cristobalgc/STM32_PID_CONTROLLER/README.md

# STM32_PID_CONTROLLER
A PID Controller with configurable parameters using LCD and a rotary encoder.
