cristobalgc/STM32_PID_CONTROLLER/Doc/Stm32F103_Eval_Doc.tex

\documentclass[10pt,a4paper,oneside]{article}
\include{Formato}
%--------------------------------------------------------------------------------------------------
\begin{document}

% PORTADA %%%%%%%%%%%%%%%%%%%%%%%%%%%%%%%%%%%%%%%%%%%%%%%%%%%%%%%%%%%%%%%%%%%%%%%%%%%%%%%%%%%%%%%%%%
\pagestyle{empty}

\begin{center} 
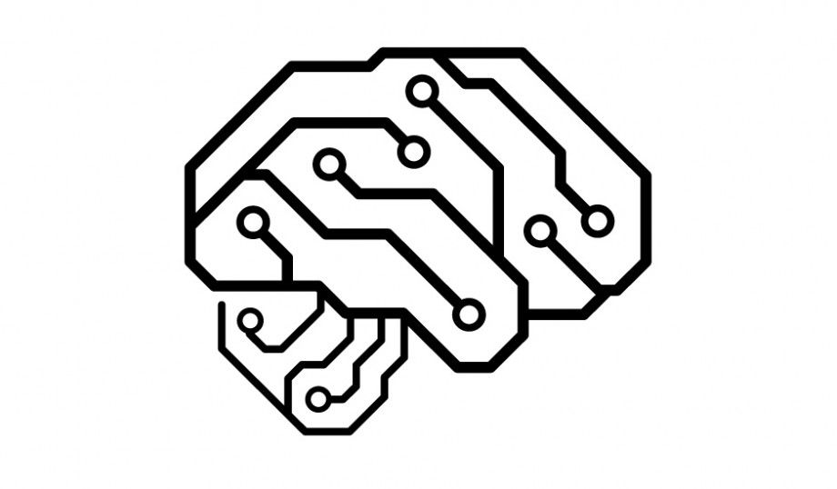
[picture p1: Doc/Imagenes/PCB_Brain_circuit.png]
 
\end{center}

\large

\vspace{3cm}

\begin{center}
{\setlength\arrayrulewidth{2pt}
\begin{tabular}{r|p{9.8cm}}
\arrayrulecolor{udc}
\colorbox{udc}{\textcolor{white}{\bf TÍTULO}}      
&	DISEÑO Y CONSTRUCCION DE UNA PLACA DE DESARROLLO PARA EL MICROCONTROLADOR STM32F103C8T6  \\[2cm]
%\colorbox{udc}{\textcolor{white}{\bf GRADO}}       & Dual en Ingeñaría Eléctrica    \\[1cm]
\colorbox{udc}{\textcolor{white}{\bf AMBITO}}       & Ingenería Electrónica    \\[1cm]
\colorbox{udc}{\textcolor{white}{\bf }}  &      \\[2cm]
\colorbox{udc}{\textcolor{white}{\bf AUTOR}}  &	Garcia Camoira Cristobal  \\[2cm]
%                                                  &	Apellido1 Apellido 2, Nombres  \\[2cm]
\colorbox{udc}{\textcolor{white}{FECHA}}       &	Febrero de 2022
\end{tabular}}
\end{center}
\normalsize
% FIN DE LA PORTADA %%%%%%%%%%%%%%%%%%%%%%%%%%%%%%%%%%%%%%%%%%%%%%%%%%%%%%%%%%%%%%%%%%%%%%%%%%%%%%%%%%%%%%%%%%%%%%%%%%%%%%%%%%%%% -----------------------------------------------------------------------------------------------------------------------------------
\cleardoublepage

% Índice de contenidos
\pagestyle{plain}
\renewcommand{\contentsname}{Índice}
{\hypersetup{hidelinks}\tableofcontents}

\cleardoublepage

% Página que contiene el índice de listas de figuras
\phantomsection
\renewcommand*\listfigurename{Listado de figuras}
\addcontentsline{toc}{section}{\listfigurename}
{\hypersetup{hidelinks}\listoffigures}
\addtocontents{lof}{\protect\thispagestyle{plain}}

% Página que contiene el índice de listas de tablas
%\cleardoublepage
\phantomsection
\renewcommand*\listtablename{Listado de tablas}
\addcontentsline{toc}{section}{\listtablename}
{\hypersetup{hidelinks}\listoftables}
\addtocontents{lot}{\protect\thispagestyle{plain}}

% Página que contiene el índice de listados de programación
\renewcommand\lstlistlistingname{Listado de códigos de programación}
\renewcommand\lstlistingname{Código}
%\cleardoublepage
\phantomsection
\addcontentsline{toc}{section}{\lstlistlistingname}
{\hypersetup{hidelinks}\lstlistoflistings}
{\protect\thispagestyle{plain}}

% Final del índice -----------------------------------------------------------------------------------------------------------------------------------

\cleardoublepage %-----------------------------------------------------------------------------------------------------

\pagestyle{fancy}

\addcontentsline{toc}{section}{Introducción}%--------------------------------------------------------------------------------
\section*{Introducción}

El presente proyecto tiene como objetivo la realización de un sistema de evaluación que nos permita el uso de diferentes periféricos así como el uso de diferentes tipos de comunicación con diversos dispositivos. 

\section*{Características técnicas}

Este sistema poseerá las siguientes salidas:

\begin{enumerate}
	\item Salida para comunicación UART
	\item Salida para comunicación IIC
	\item Salida PWM
\end{enumerate}

Y también las siguientes entradas:

\begin{enumerate}
	\item Entrada ADC
	\item Entrada JTAG para la programación del microcontrolador
	\item Entrada para una batería auxiliar tipo CR2032 que usara el dispositivo DS1302 para mantener la hora en caso de que se desconecte la alimentación  principal.
\end{enumerate}

Este sistema incorporara internamente un LCD de 20 caracteres x 4 lineas que se conectara a nuestro microcontrolador través del expansor de entradas/salidas IIC PCF8574, ademas incorpora un DS1302, un reloj en tiempo real el cual se ha pensado manejar con el sistema de conexión 1 wire, para el cual se usara el periférico interno SPI en modo half duplex.Todo esto nos permitirá el desarrollo de drivers para el correcto manejo de los dispositivos internos que posee y aprender de ello. Ademas las salidas que tenemos disponibles nos servirán para manejar otro tipo de dispositivos, dado que tenemos salida PWM, IIC y UART y una entrada para un ADC.

El microcontrolador que se usara en el proyecto pertenece al fabricante ST microelectronics, concretamente es el STM32F103C8T6, que incorporaremos a nuestro sistema ya en una placa de evaluación comúnmente denominada por la red de internet como "`Blue pill"', de hecho, si descargamos las librerías adecuadas se puede usar el entrono de Arduino para su programación, como si de un Arduino se tratase.

La alimentación de este sistema se hará a través del conector micro USB del que dispone la placa de evaluación de ST, un cargador de teléfono móvil sera mas que suficiente, 5V 1A, el resto de componentes internos se nutrirán de la alimentación de 5V que proporciona la placa de evaluación de ST dado que usa un regulador interno para ello y la corriente que proporciona es capaz de nutrir de forma suficiente al resto de componentes.

\vspace{0.5cm}

\section{Lista de materiales y presupuesto}

% Table generated by Excel2LaTeX from sheet 'BOM'
\begin{center}
\begin{longtable}{|l|l|l|l|l|}

%primera parte de la tabla
\rowcolor[rgb]{ .357,  .608,  .835} \textcolor[rgb]{ 1,  1,  1}{\textbf{Category}} & \textcolor[rgb]{ 1,  1,  1}{\textbf{Quantity}} & \textcolor[rgb]{ 1,  1,  1}{\textbf{References}} & \textcolor[rgb]{ 1,  1,  1}{\textbf{Value}} & \textcolor[rgb]{ 1,  1,  1}{\textbf{Unit Cost}} \\
\endfirsthead
%Continuación de la tabla \\
\rowcolor[rgb]{ .357,  .608,  .835} \textcolor[rgb]{ 1,  1,  1}{\textbf{Category}} & \textcolor[rgb]{ 1,  1,  1}{\textbf{Quantity}} & \textcolor[rgb]{ 1,  1,  1}{\textbf{References}} & \textcolor[rgb]{ 1,  1,  1}{\textbf{Value}} & \textcolor[rgb]{ 1,  1,  1}{\textbf{Unit Cost}} \\
\endhead

% ultima parte de la tabla por pagina
%\multicolumn{6}{c}{ \textit{Presupuesto de dispositivos}-(ver pag siguiente)}  \\ 
\caption[Lista de materiales]{Lista de materiales}
%Continua en la siguiente pagina \\
\endfoot

% ultima parte de la tabla
\caption[Lista de materiales]{Lista de materiales}\label{TABLA1}
\endlastfoot

\midrule
Capacitors & 2      & C1-C2  & 6pF    & €0,35 \\
\midrule
Capacitors & 1      & C3     & 1.0u   & €0,35 \\
\midrule
Capacitors & 2      & C4-C5  & 10n    & €0,35 \\
\midrule
Capacitors & 1      & C6     & 100n   & €1,00 \\
\midrule
Resistors & 1      & R1     & 1k     & €0,15 \\
\midrule
Resistors & 9      & R2-R10 & 10k    & €0,15 \\
\midrule
Integrated Circuits & 1      & U1     & STM32F103 & €3,50 \\
\midrule
Integrated Circuits & 1      & U2     & 74HC14 & €1,00 \\
\midrule
Integrated Circuits & 1      & U3     & PCF8574 & €2,50 \\
\midrule
Integrated Circuits & 1      & U6     & DS1302 & €1,00 \\
\midrule
Miscellaneous & 2      & ADC,UART & CONN-SIL3 & €0,40 \\
\midrule
Miscellaneous & 1      & BATT   & CONN-H2 & €0,35 \\
\midrule
Miscellaneous & 2      & IIC,JTAG & CONN-H4 & €0,40 \\
\midrule
Miscellaneous & 1      & L1     &        & €0,25 \\
\midrule
Miscellaneous & 1      & LCD\_20X4 & CONN-H16 & €4,50 \\
\midrule
Miscellaneous & 1      & PWM    & CONN-SIL5 & €0,25 \\
\midrule
Miscellaneous & 1      & RENC1  & ROTARY\_ENCODER1 & €2,50 \\
\midrule
Miscellaneous & 1      & X1     & CRYSTAL & €0,50 \\
\midrule
\textbf{Total} &        &        &        & €22,2 \\
\bottomrule

\end{longtable}
\end{center}

\section{Montaje}
\subsection{Guía de montaje}%------------------------------------------------------------------------------------------------------

El proceso de insolado no se explica en esta guía, con lo cual se explica el proceso de montaje una vez tenemos la PCB tras ese proceso y el proceso de taladrado de los agujeros. Se incluye como ejemplo la Figura (\ref{fig:001}).

\begin{figure}[H]
\centering
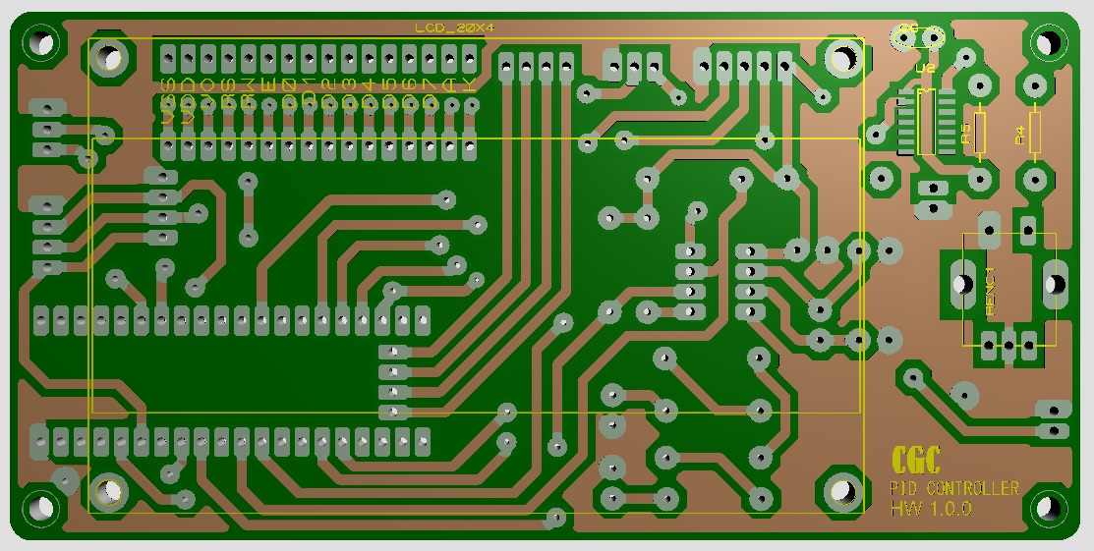
[picture p2: Doc/Imagenes/PCB_CARA_DELANTERA.jpg]

\caption[Vista de las pistas de la cara delantera de la PCB tras el proceso de insolado]{Pistas PCB cara delantera}
\label{fig:001}
\end{figure}

\begin{figure}[H]
\centering
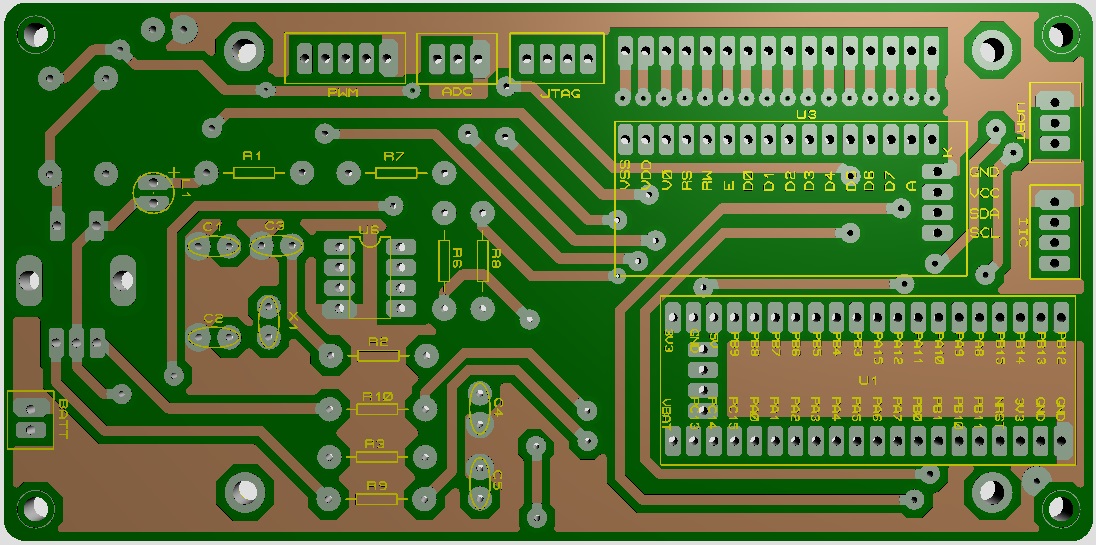
[picture p3: Doc/Imagenes/PCB_CARA_TRASERA.jpg]

\caption[Vista de las pistas de la cara trasera de la PCB tras el proceso de insolado]{Pistas PCB cara trasera}
\label{fig:002}
\end{figure}

Teniendo como referencia la PCB por la cara delantera,  tal y como se representa en la imagen (\ref{fig:003}), los círculos señalados en amarillo son las vías, es decir, los puntos que conectan ambas caras, delantera y trasera, esta conexión la haremos con unos cables rígidos que circularan de un lado al otro de la placa, soldados por ambas caras, para ello se puede usar un trozo de cable rígido pelado previamente. 

\begin{figure}[H]
\centering
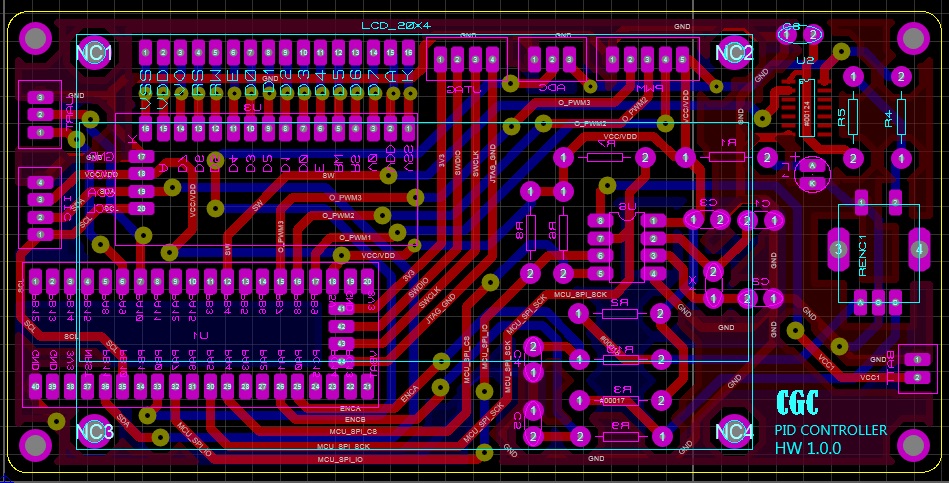
[picture p4: Doc/Imagenes/PCB_CARA_DELANTERA_VIAS.jpg]

\caption[Vista de las vias de la cara delantera de la PCB tras el proceso de insolado]{Vías PCB cara delantera}
\label{fig:003}
\end{figure}

Una vez soldadas las vías, se recomienda ir soldando los componentes que vayan de menor a mayor volumen o tamaño para facilitar este proceso, se recomienda empezar por soldar los que van por la parte trasera (\ref{fig:005}).

Nota: No es necesario incorporar los componentes R6, R7 y R8 al circuito, en su defecto es necesario soldar un cable en cada uno de los pads de las resistencias para unir ambas caras de la placa, como si de vías se tratasen.

Por la cara delantera irán soldados los componentes: R4, R5, U2, C6, RENC1 y LCD20X4. El resto de componentes irán soldados por la parte trasera.

\begin{figure}[H]
\centering
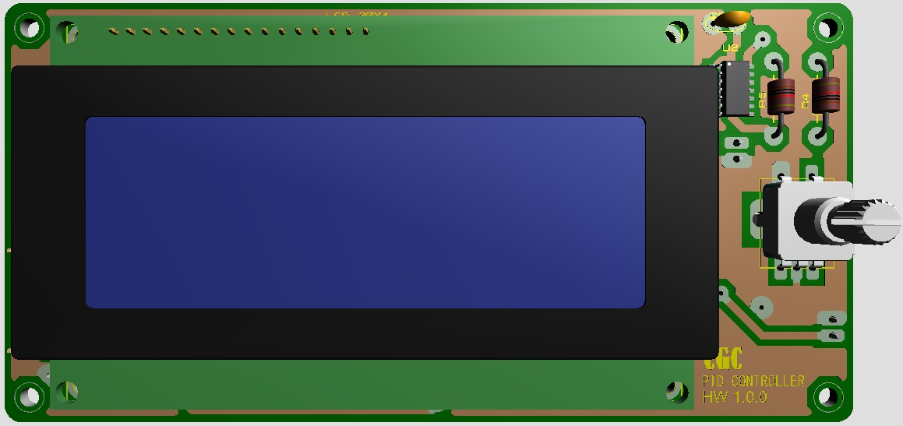
[picture p5: Doc/Imagenes/PCB_COMPONENTES_CARA_DELANTERA.jpg]

\caption[Vista de los componentes de la cara delantera de la PCB]{Componentes de la cara delantera}
\label{fig:004}
\end{figure}

\begin{figure}[H]
\centering
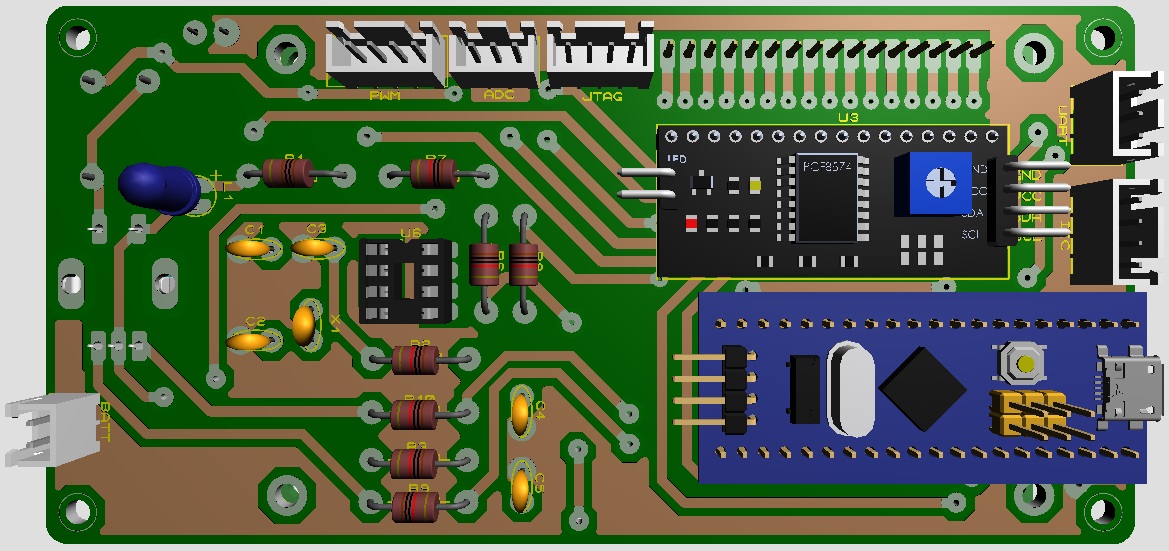
[picture p6: Doc/Imagenes/PCB_COMPONENTES_CARA_TRASERA.jpg]

\caption[Vista de los componentes de la cara trasera de la PCB]{Componentes de la cara trasera}
\label{fig:005}
\end{figure}

\begin{figure}[h]
\centering
\includemovie[
 poster,controls,
 3Droo=23, 3Dcoo=-1 9.8765 0
 ]{17cm}{9cm}{Model3D/PCB_3D_MODEL.u3d}
 \caption[Vista 3D del modelo de la PCB]{Modelo 3D de la PCB}
\label{fig:PCB_3D_MODEL}
\end{figure}

\subsection{Programación del dispositivo}%------------------------------------------------------------------------------------------------------

Para la programación de este dispositivo se deben ejecutar los siguientes pasos:

\begin{enumerate}
	\item Conectar los pines del conector JTAG con sus homólogos en el programador stlink-V2.
	\item El código se encuentra en la siguiente dirección: \url{https://github.com/cristobalgc/STM32_PID_CONTROLLER}
	\item Esta sección se completara cuando el código este acabado.
\end{enumerate}

\section{Códigos de programación}%-------------------------------------------------------------------------------------------------

El código de programación del dispositivo estará localizado en el siguiente repositorio de github: \url{https://github.com/cristobalgc/STM32_PID_CONTROLLER}

\bigskip

\section{Sección Planos}%------------------------------------------------------------------------------------------------------

A continuación se introducen los planos. Cada plano figura en una página separada con numeración impar. La parte posterior de esas hojas deben estar en blanco.

%\pagestyle{fancy}

% FIN DE LA PORTADA
%%%%%%%%%%%%%%%%%%%%%%%%%%%%%%%%%%%%%%%%%%%%%%%%%%%%%%%%%%%%%%%%%%%%%%%%%%%%%%%%%%%%%%%%%%%%%%%%%%%%%%%%%%%%%%%%%%%%%%%%%%%%%%%%%%%%%%

% Principio Plano A4 ---------------------------------------------------------------------------------------------------
\cleardoublepage
\begin{Plano}[!htb]
\addcontentsline{toc}{subsection}{Esquema electrónico de la placa Blue pill} % Nombre que aparecerá en la lista de planos
\includepdf[pages=-]{Planos/STM32F103C8T6-Blue_Pill-schematic.pdf} % Ruta y nombre del plano A4
\caption[Esquema electrónico de la placa Blue pill]{} % Página \thepage}
\label{BluePillSch} % Etiqueta para referenciar el plano
\end{Plano}

% Fin Plano A4 --------------------------------------------------------------------------------------------------------

% Principio Plano A4 ---------------------------------------------------------------------------------------------------
\cleardoublepage
\begin{Plano}[!htb]
\addcontentsline{toc}{subsection}{Esquema electrónico del expansor de entradas-salidas IIC} % Nombre que aparecerá en la lista de planos
\includepdf[pages=-]{Planos/PCF8574_IO_Expander_schematic.pdf} % Ruta y nombre del plano A4
\caption[Esquema electrónico del expansor de entradas-salidas IIC]{} % Página \thepage}
\label{PCF8574Sch} % Etiqueta para referenciar el plano
\end{Plano}

% Fin Plano A4 --------------------------------------------------------------------------------------------------------

% Principio Plano A3 ---------------------------------------------------------------------------------------------------
\cleardoublepage

\begin{landscape} % se indica que empieza una página apaisada
\afterpage

\KOMAoptions{paper=A3,paper=landscape,pagesize}
\recalctypearea
\begin{Plano}[!htb]
\addcontentsline{toc}{subsection}{Placa de evaluación ST} % Nombre que aparecerá en la lista de planos
\includepdf[pages=-]{Planos/PCB_PLACA_EVAL_ST_SCHEMATIC.pdf} % Ruta y nombre del plano A3
\caption[Placa de evaluación ST]{}
\label{PacaEvalSch} % Etiqueta para referenciar el plano
\end{Plano}

\cleardoublepage

\KOMAoptions{paper=A4,pagesize}
\recalctypearea
\end{landscape} % se indica que acaba una página apaisada
% Fin Plano A3 --------------------------------------------------------------------------------------------------------

\cleardoublepage

% Principio Plano A4 ---------------------------------------------------------------------------------------------------
\cleardoublepage
\begin{Plano}[!htb]
\addcontentsline{toc}{subsection}{Fotolito PCB parte delantera} % Nombre que aparecerá en la lista de planos
\includepdf[pages=-]{Planos/FOTOLITO_PCB_PARTE_DELANTERA.pdf} % Ruta y nombre del plano A4
\caption[Fotolito PCB parte delantera]{} % Página \thepage}
\label{FotolitoTOP} % Etiqueta para referenciar el plano
\end{Plano}

% Fin Plano A4 --------------------------------------------------------------------------------------------------------

% Principio Plano A4 ---------------------------------------------------------------------------------------------------
\cleardoublepage
\begin{Plano}[!htb]
\addcontentsline{toc}{subsection}{Fotolito PCB parte trasera} % Nombre que aparecerá en la lista de planos
\includepdf[pages=-]{Planos/FOTOLITO_PCB_PARTE_TRASERA.pdf} % Ruta y nombre del plano A4
\caption[Fotolito PCB parte trasera]{} % Página \thepage}
\label{FotolitoBOT} % Etiqueta para referenciar el plano
\end{Plano}

% Fin Plano A4 --------------------------------------------------------------------------------------------------------

%%%%%%%%%%%%%%%%%%%%%%%%%%%%%%%%%%%%%%%%%%%%%%%%%%%%%%%%%%%%%%%%%%%%%%%%%%%%%%%%%%%%%%%%%%%%%%%%%%%%%%%%%%%%%%%%%%%%%%%%%%%%%%%%%%%%%%

\end{document}
