cristobalgc/STM32_PID_CONTROLLER/Doc/Stm32F103_Eval_Doc.pdf

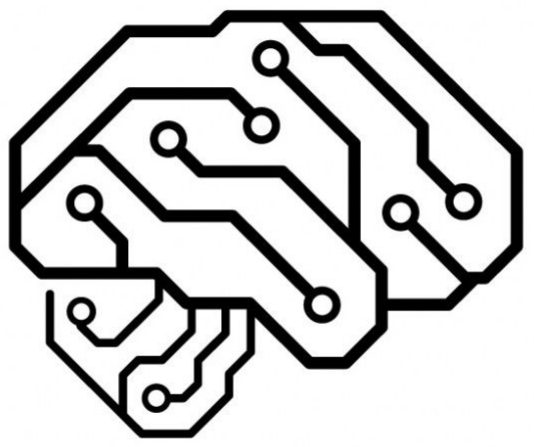
[picture p7: figure]

### T´ITULO DISENO Y CONSTRUCCION DE UNA PLACA DE ˜

### DESARROLLO PARA EL MICROCONTROLADOR

| STM32F103C8T6
GRADO | Ingener´ıa Electronica Industrial y Autom ´ | atica ´
ASIGNATURA | Nombre de la asignatura
ESTUDIANTE | Garcia Camoira Cristobal
FECHA | Octubre de 2020

## ´Indice

Listado de figuras | | 3
Listado de tablas | | 3
Listado de codigos de programaci ´ | on | 3 ´
Introduccion´ | | 4
1 Lista de materiales y presupuesto | 4
2 Montaje | | 6
2.1 Gu´ıa de montaje | | 6
2.2 Programacion del dispositivo | ´ | | 8
3 Codigos de programaci ´ | on´ | 8
4 Seccion Planos ´ | | 8
Esquema electronico de la placa Blue pill | ´ | | 9
Esquema electronico del expansor de entradas-salidas IIC | ´ | | 10
Placa de evaluacion ST | ´ | | 11
Fotolito PCB parte delantera | 12
Fotolito PCB parte trasera | 13

2

## Listado de figuras

1 | Vista de las pistas de la cara delantera de la PCB tras el proceso de insolado | | 6
2 | Vista de las pistas de la cara trasera de la PCB tras el proceso de insolado | | 6
3 | Vista de las vias de la cara delantera de la PCB tras el proceso de insolado | | 7
4 | Vista de los componentes de la cara delantera de la PCB | | 7
5 | Vista de los componentes de la cara trasera de la PCB | | 8

## Listado de tablas

1 | Lista de materiales | | 4
1 | Lista de materiales | | 5
2 | Presupuesto | | 5
Listado de codigos de programaci ´ | on´

3

## Introduccion´

El presente proyecto tiene como objetivo la realizacion de un sistema de evaluaci ´ | on que nos permita el uso ´
de diferentes perifericos as ´ | ´ı como el uso de diferentes tipos de comunicacion con diversos dispositivos. ´

## Caracter´ısticas tecnicas ´

Este sistema poseera las siguientes salidas: ´

1. Salida para comunicacion UART ´
2. Salida para comunicacion IIC ´
3. Salida PWM

Y tambien las siguientes entradas: ´

1. Entrada ADC
2. Entrada JTAG para la programacion del microcontrolador ´
3. Entrada para una bater´ıa que usara el DS1302 para que no se vaya de hora

Este sistema incorporara internamente un LCD de 20 caracteres x 4 lineas que se conectara a nuestro microcontrolador traves del expansor de entradas/salidas IIC PCF8574, ademas incorpora un DS1302, un ´
reloj en tiempo real el cual se ha pensado manejar con el sistema de conexion 1 wire (conexi ´ | on experimental), ´
para el cual intentaremos usar el periferico interno USART.Todo esto nos permitir ´ | a el desarrollo de drivers ´

para el correcto manejo de los dispositivos internos que posee y aprender de ello. Ademas las salidas que tenemos disponibles nos serviran para manejar otro tipo de dispositivos, dado que tenemos salida PWM, IIC ´ y UART y una entrada para un ADC.
El microcontrolador que se usara en el proyecto pertenece al fabricante ST microelectronics, concretamen-
te es el STM32F103C8T6, que incorporaremos a nuestro sistema ya en una placa de evaluacion com ´ | unmente ´

denominada por la red de internet como ✭✭Blue pill✮✮, de hecho, si descargamos las librer´ıas adecuadas se puede usar el entrono de Arduino para su programacion, como si de un Arduino se tratase. ´
La alimentacion de este sistema se har ´ | a a trav ´ | es del conector micro USB del que dispone la placa de ´
evaluacion de ST, un cargador de tel ´ | efono m ´ | ovil sera mas que suficiente, 5V 1A, el resto de componentes ´
internos se nutriran de la alimentaci ´ | on de 5V que proporciona la placa de evaluaci ´ | on de ST dado que usa un ´

regulador interno para ello.

## 1 Lista de materiales y presupuesto

Category | Quantity | References | Value | Unit Cost
Capacitors | 2 | C1,C2 | 6pF | e0,35
Capacitors | 1 | C3 | 1.0u | e0,35

Tabla 1: Lista de materiales

4

Category | Quantity | References | Value | Unit Cost
Capacitors | 2 | C4,C5 | 10n | e0,35
Resistors | 1 | R1 | 1k | e0,15
Resistors | 8 | R2,R3,R4,R6,R7,R8,R9,R10 | 10k | e0,15
Resistors | 1 | R5 | 100R | e0,15
Resistors | 1 | R11 | 100k | e0,15
Resistors | 1 | R12 | 4k7 | e0,15
Integrated Circuits | 1 | U1 | STM32F103 | e3,50
Integrated Circuits | 1 | U2 | DS1302 | e2,50
Integrated Circuits | 1 | U3 | PCF8574 | e2,50
Transistors | 2 | Q1,Q2 | 2N7002 | e0,50
Miscellaneous | 3 | ADC,PWM,UART | CONN-SIL3 | e0,40
Miscellaneous | 1 | BAT1 | BATTERY | e2,00
Miscellaneous | 2 | IIC,JTAG | CONN-H4 | C0,40
Miscellaneous | 1 | L1 | | e0,25
Miscellaneous | 1 | LCD 20X4 | CONN-H16 | e4,00
Miscellaneous | 1 | RENC1 | ROTARY ENCODER1 | e2,50
Miscellaneous | 1 | X1 | CRYSTAL | e0,50

Tabla 1: Lista de materiales

Category | Quantity | Unit Cost
Capacitors | 5 | 1,75
Resistors | 12 | 1,8
Integrated Circuits | 3 | 8,5
Transistors | 2 | 1
Miscellaneous | 10 | 11,25
Total | 32 | 24,3

Tabla 2: Presupuesto

5

## 2 Montaje

### 2.1 Gu´ıa de montaje

El proceso de insolado no se explica en esta gu´ıa, con lo cual se explica el proceso de montaje una vez tenemos la PCB tras ese proceso y el proceso de taladrado de los agujeros. Se incluye como ejemplo la Figura (1).

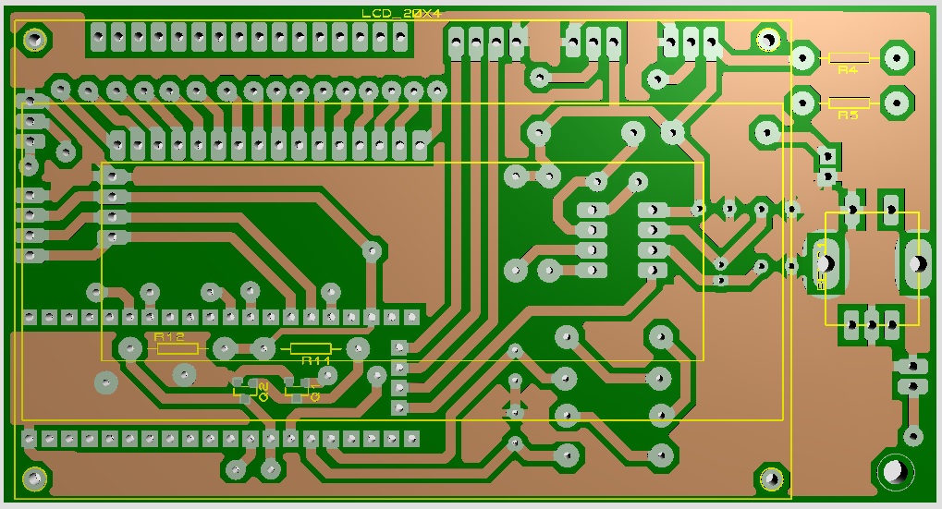
[picture p8: figure]

Figura 1: Pistas PCB cara delantera

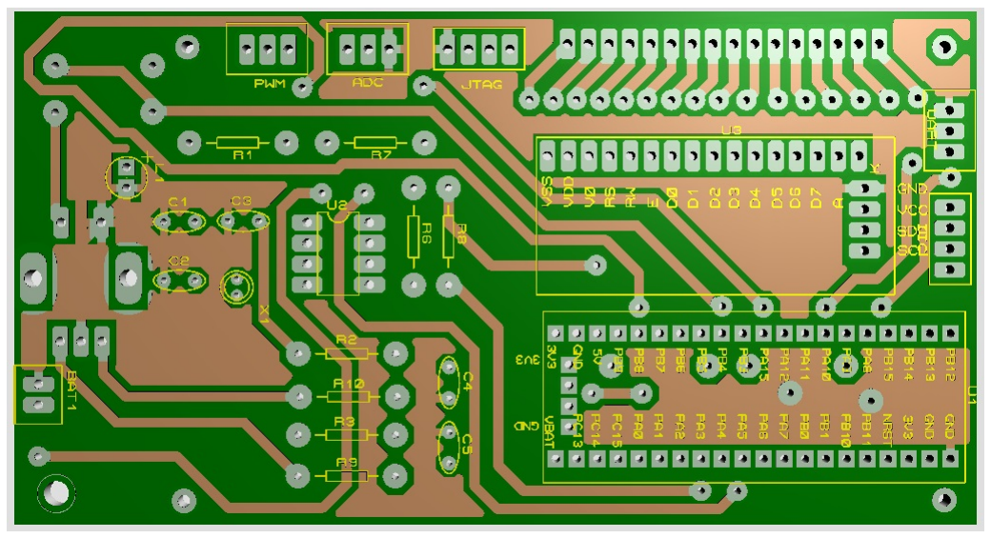
[picture p9: figure]

Figura 2: Pistas PCB cara trasera

Teniendo como referencia la PCB por la cara delantera, tal y como se representa en la imagen (3), los
c´ırculos senalados en rojo son las v ˜ | ´ıas, es decir, los puntos que conectan ambas caras, delantera y trasera,
esta conexion la haremos con unos cables r ´ | ´ıgidos que circularan de un lado al otro de la placa, soldados por

ambas caras, para ello se puede usar un trozo de cable r´ıgido pelado previamente.

6

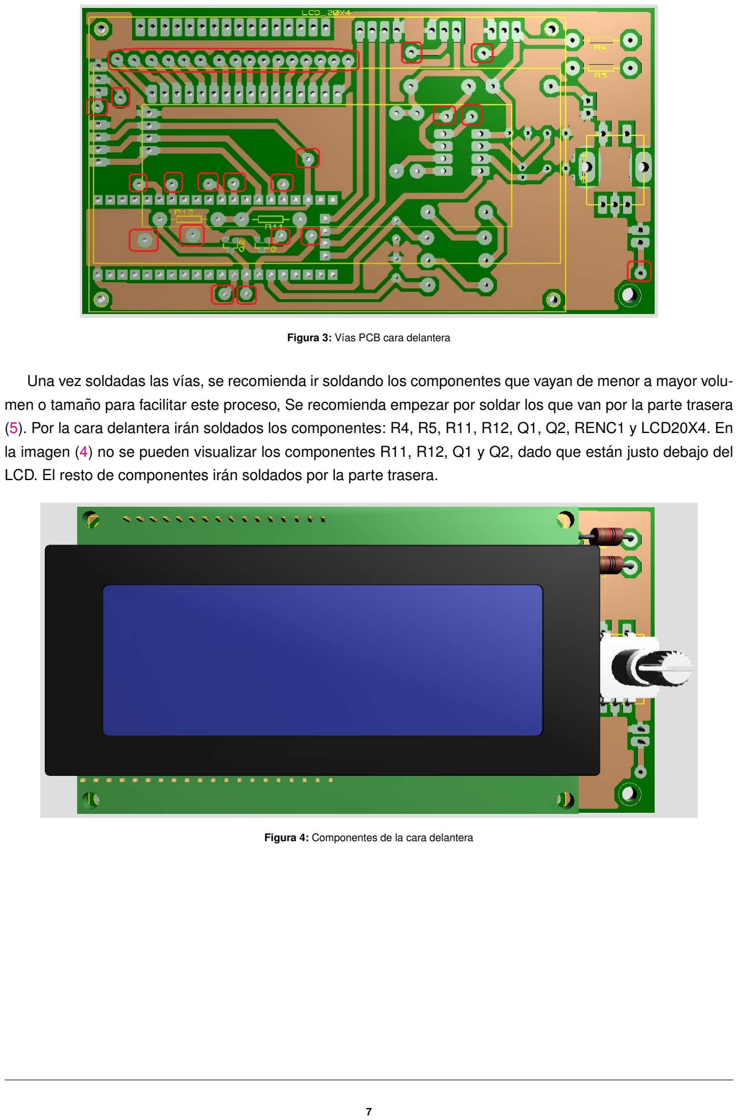
[picture p10: page 7]

Figura 3: V´ıas PCB cara delantera

Una vez soldadas las v´ıas, se recomienda ir soldando los componentes que vayan de menor a mayor volu-men o tamano para facilitar este proceso, Se recomienda empezar por soldar los que van por la parte trasera ˜ (5). Por la cara delantera iran soldados los componentes: R4, R5, R11, R12, Q1, Q2, RENC1 y LCD20X4. En ´ la imagen (4) no se pueden visualizar los componentes R11, R12, Q1 y Q2, dado que estan justo debajo del ´ LCD. El resto de componentes iran soldados por la parte trasera. ´

Figura 4: Componentes de la cara delantera

7

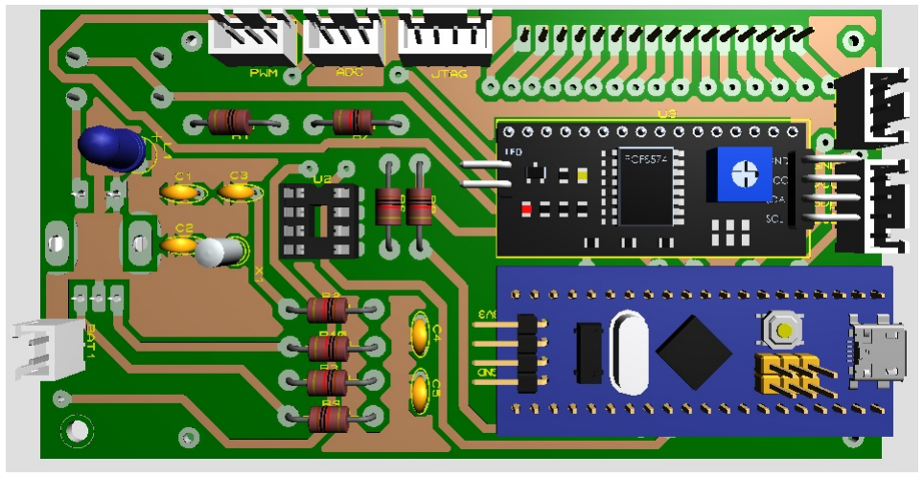
[picture p11: figure]

Figura 5: Componentes de la cara trasera

### 2.2 Programacion del dispositivo ´

Para la programacion de este dispositivo se deben ejecutar los siguientes pasos: ´

1. Conectar los pines del conector JTAG con sus homologos en el programador stlink-V2. ´
2. El codigo se encuentra en la siguiente direcci ´ | on: ´ | https://github.com/cristobalgc/STM32_PID_CONTROLLER
3. Esta seccion se completara cuando el c ´ | odigo este acabado. ´
3 Codigos de programaci ´ | on´
El codigo de programaci ´ | on del dispositivo estar ´ | a localizado en el siguiente repositorio de github: ´ | https:

//github.com/cristobalgc/STM32_PID_CONTROLLER

## 4 Seccion Planos ´

A continuacion se introducen los planos. Cada plano figura en una p ´ | agina separada con numeraci ´ | on impar. ´

La parte posterior de esas hojas deben estar en blanco.

8

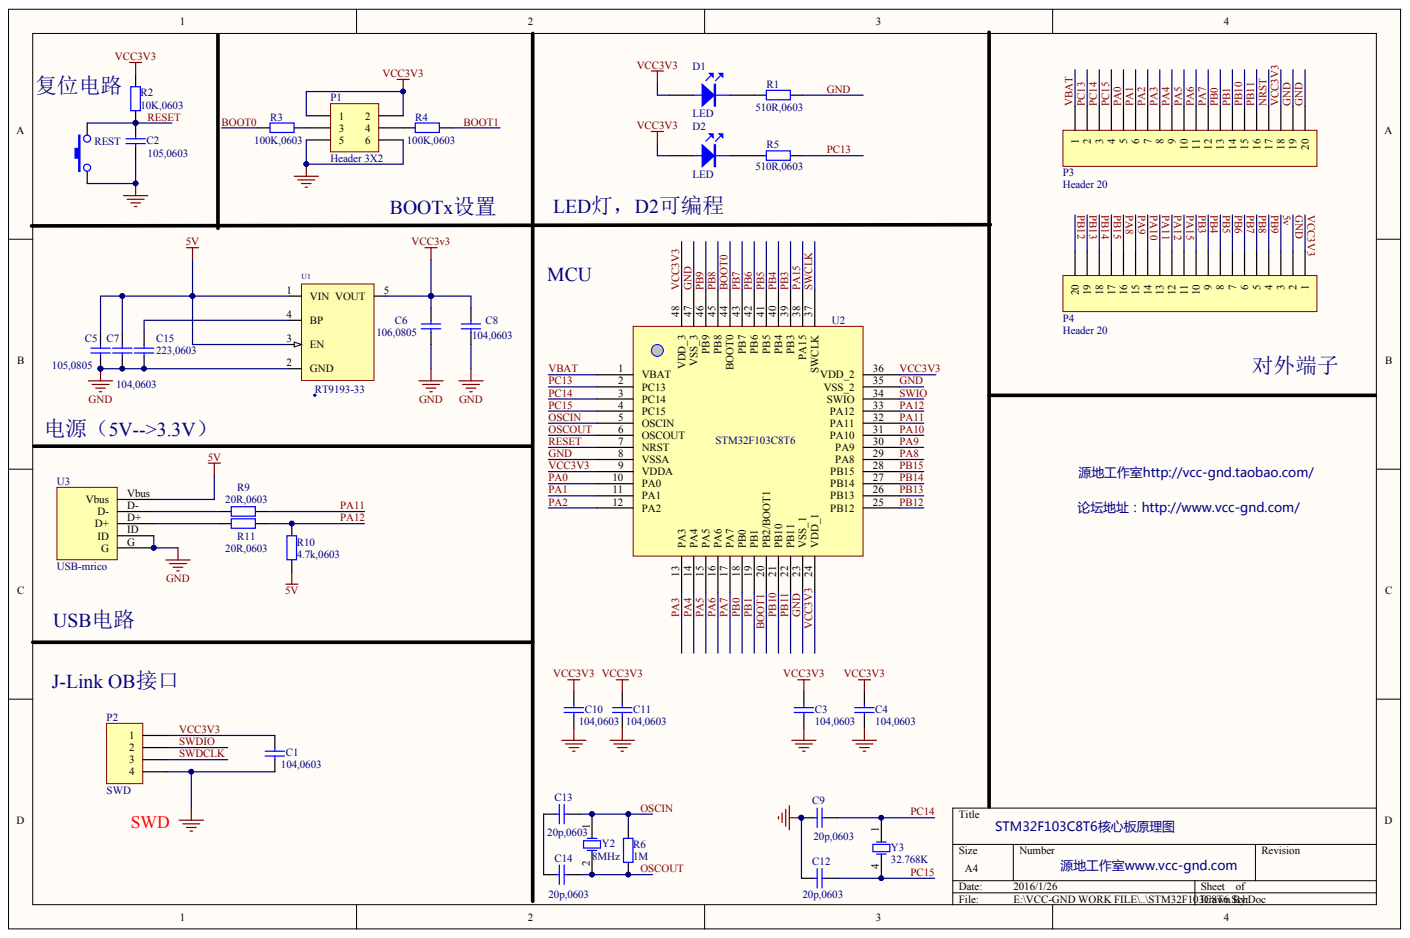
[picture p12: page 9]

36 WCLK ³⁷ PA¹⁵ ³⁸ PB³ ³⁹ PB⁴ ⁴⁰ PB⁵ ⁴¹ PB⁶ ⁴² PB⁷ ⁴³ BOOT⁰ ⁴⁴ PB⁸ ⁴⁵ PB⁹ ⁴⁶ VSS_3 47 VDD_3 48

源地工作室http://vcc-gnd.taobao.com/

论坛地址：http://www.vcc-gnd.com/

源地工作室www.vcc-gnd.com

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

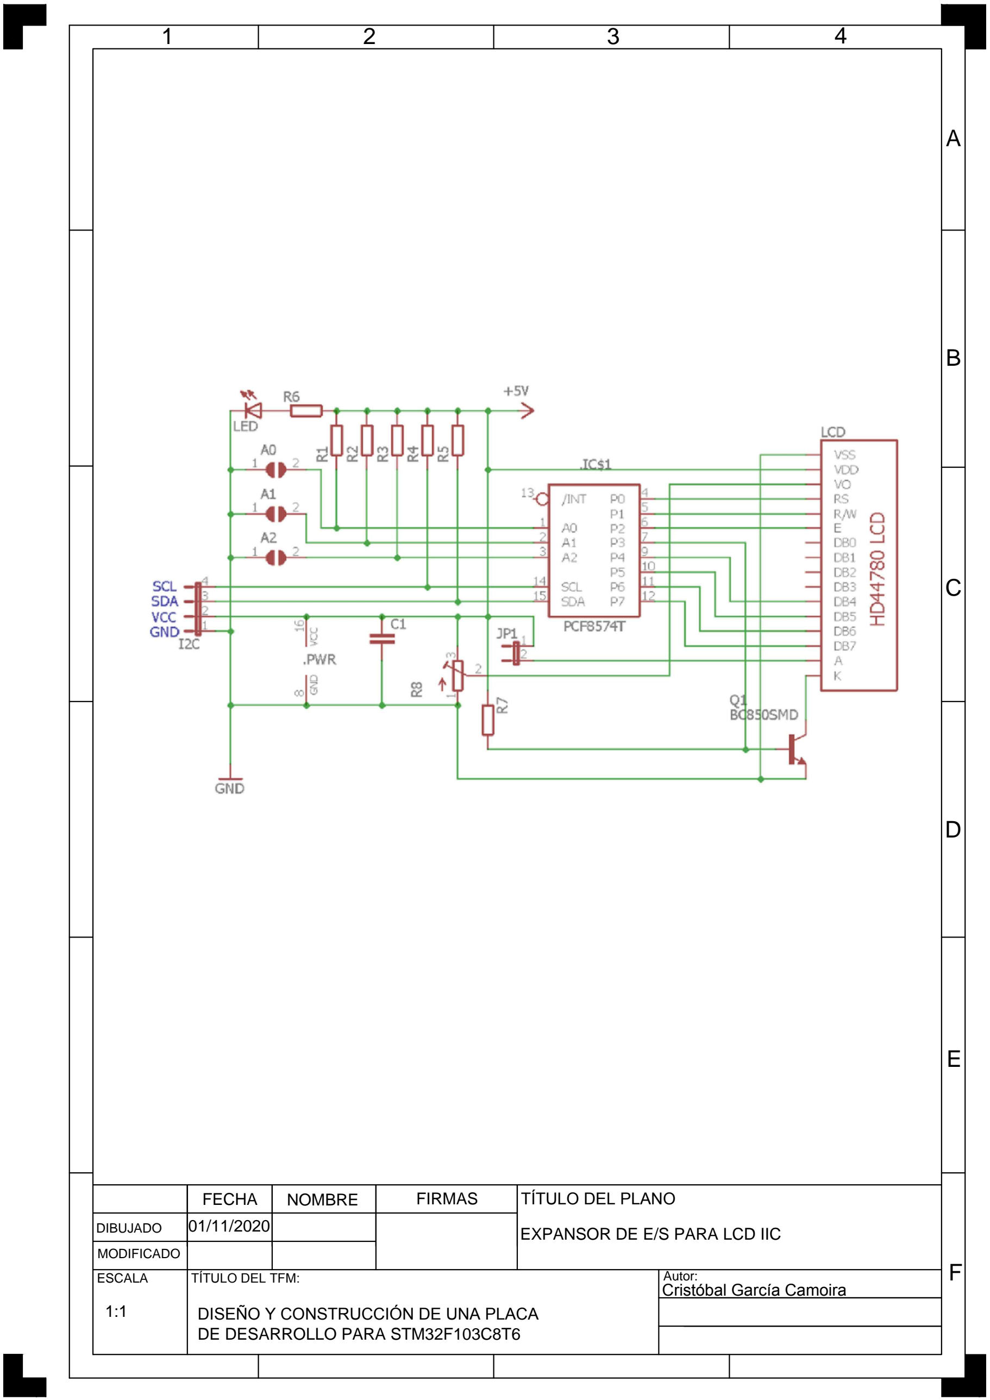
[picture p13: figure]

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

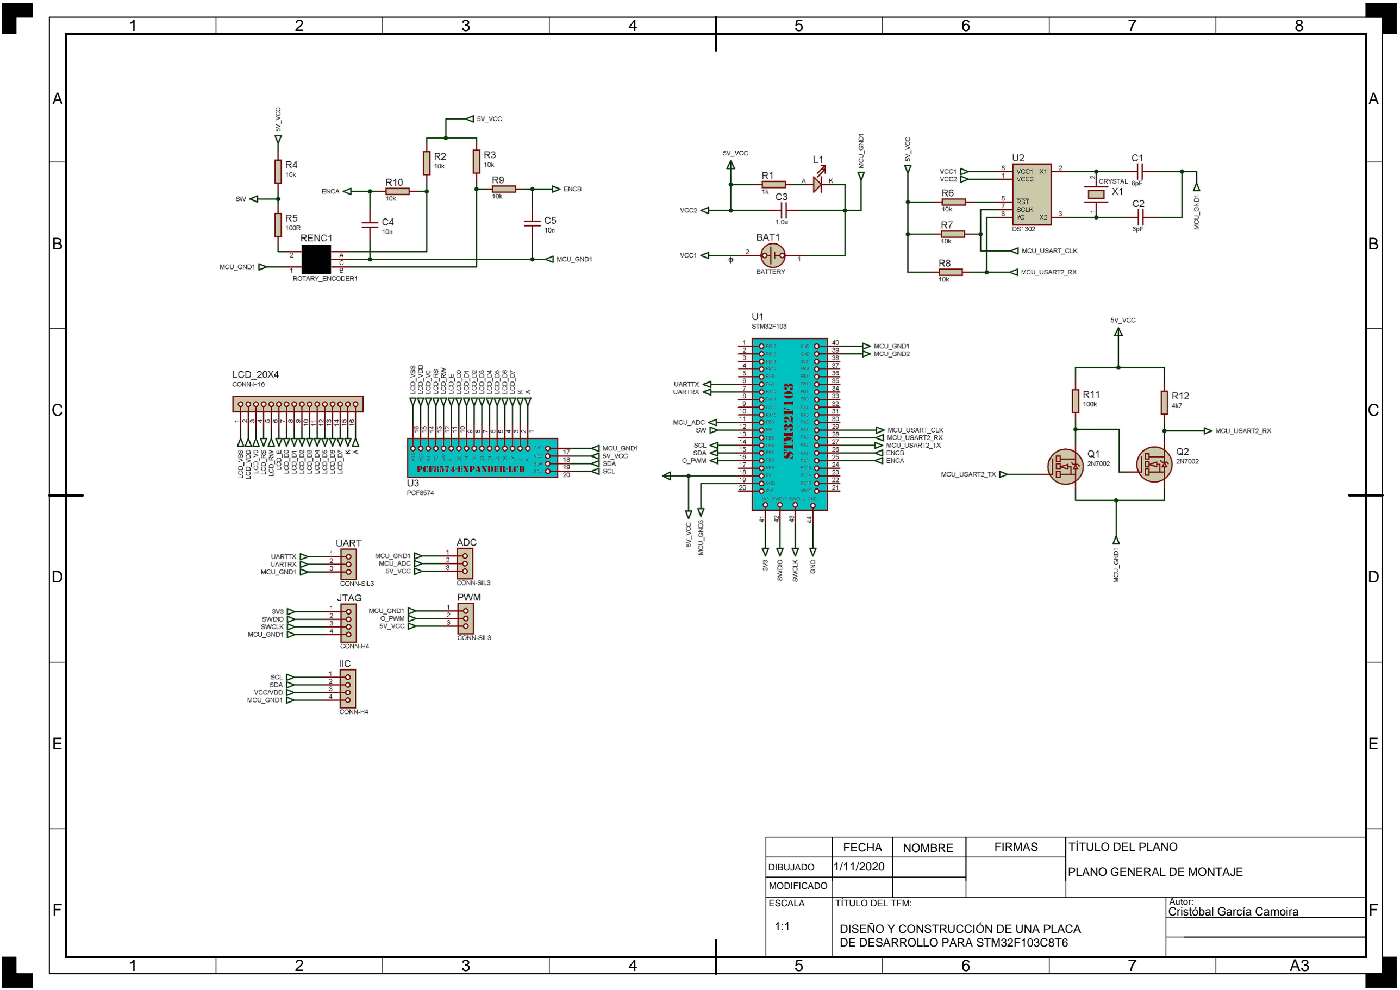
[picture p14: page 11]

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

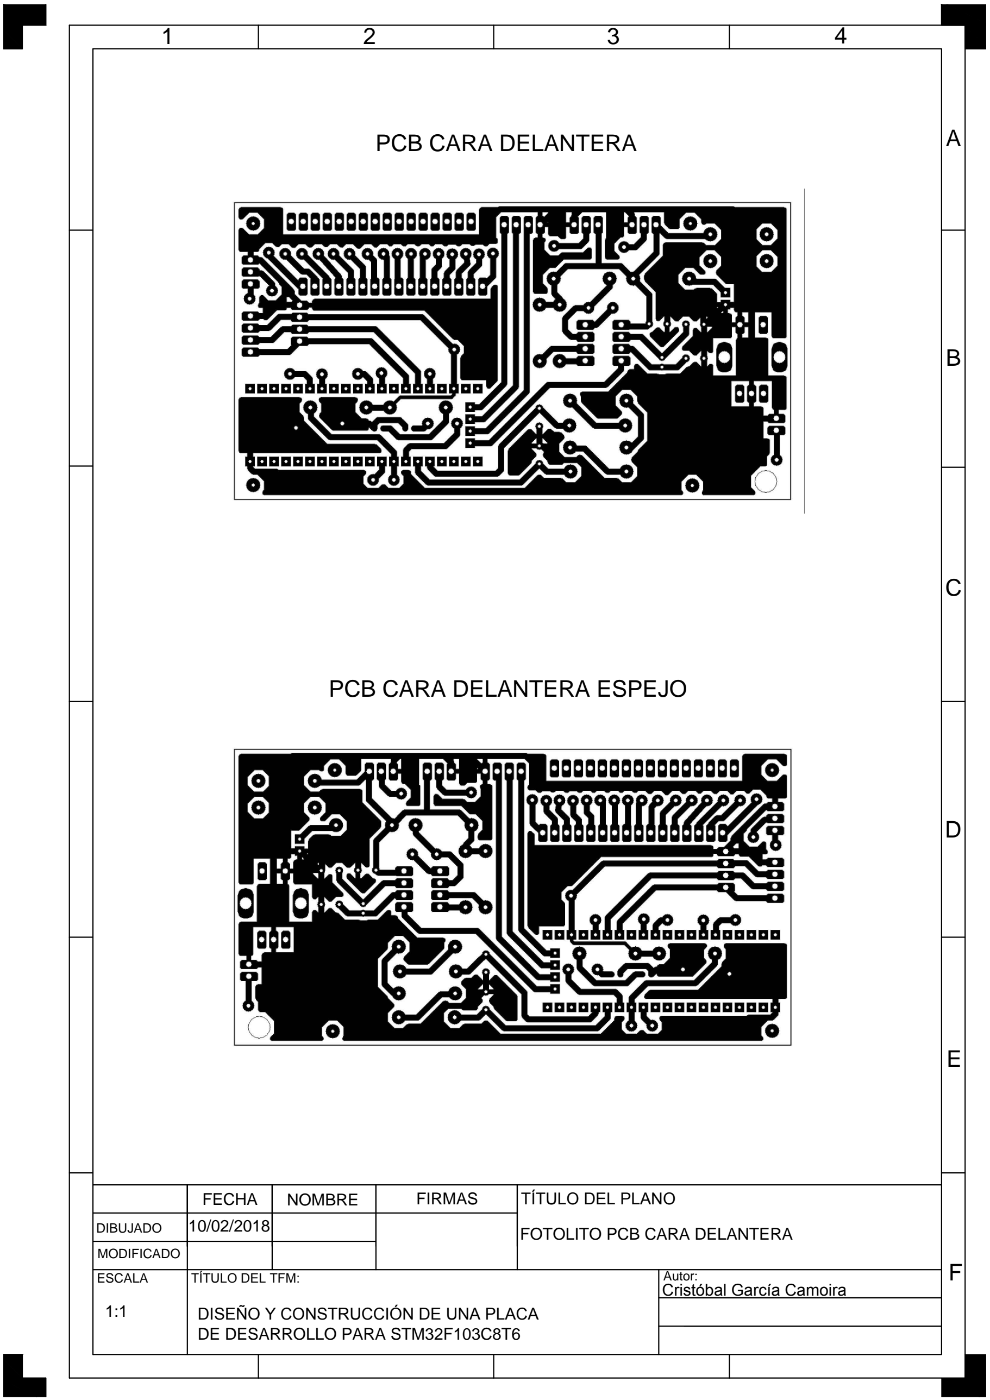
[picture p15: figure]

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

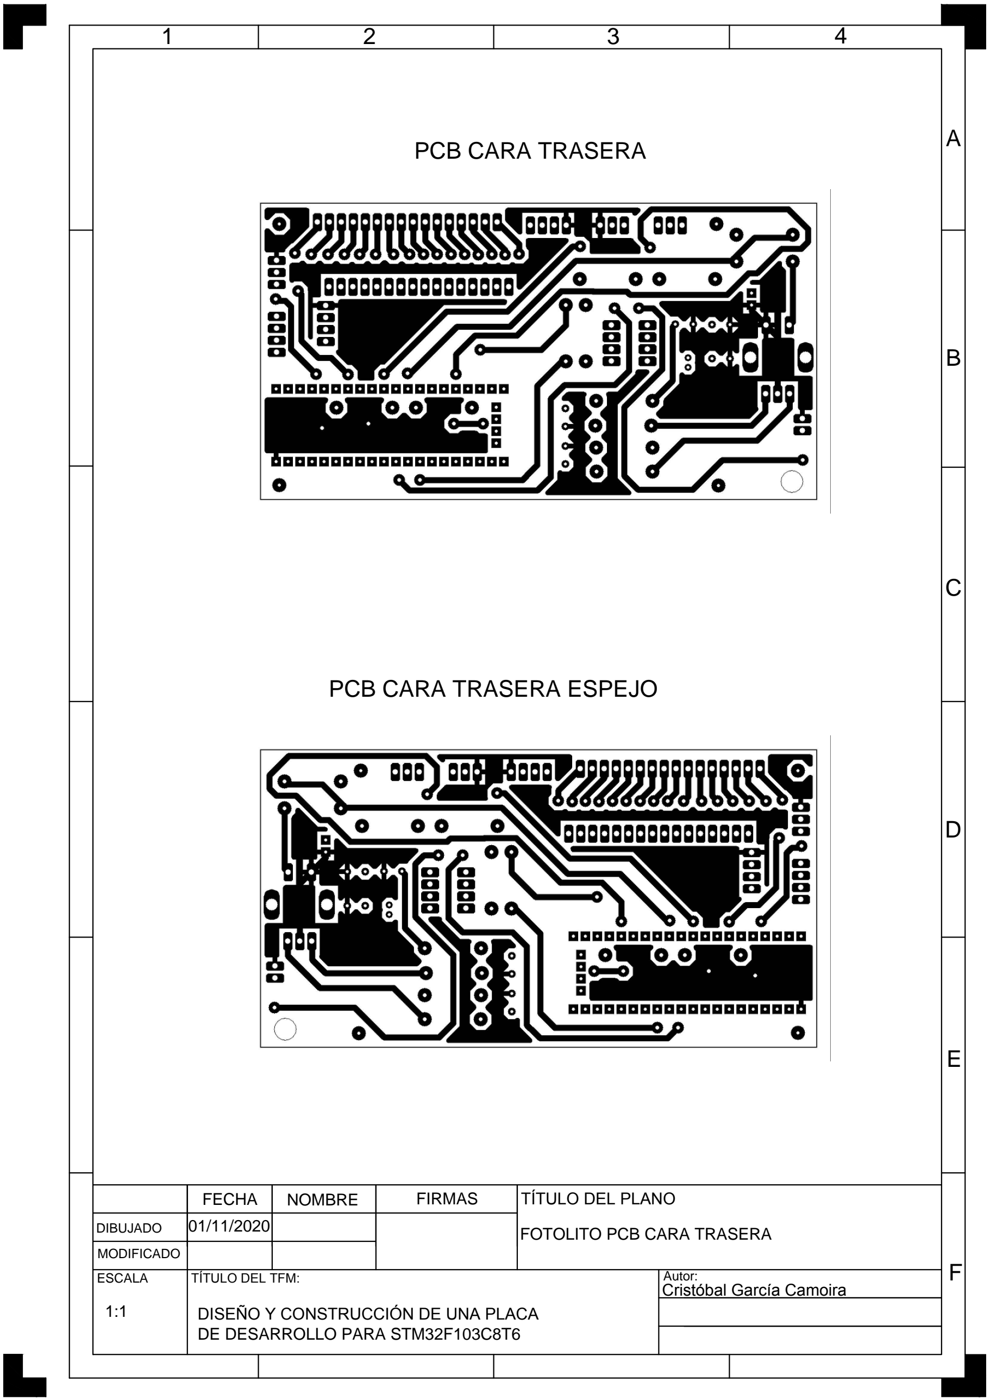
[picture p16: figure]
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
