cristobalgc/STM32_PID_CONTROLLER/PCB Design/Exported Schematics/HWV1.0/PCB_ST_TOP_MIRROR.BMP

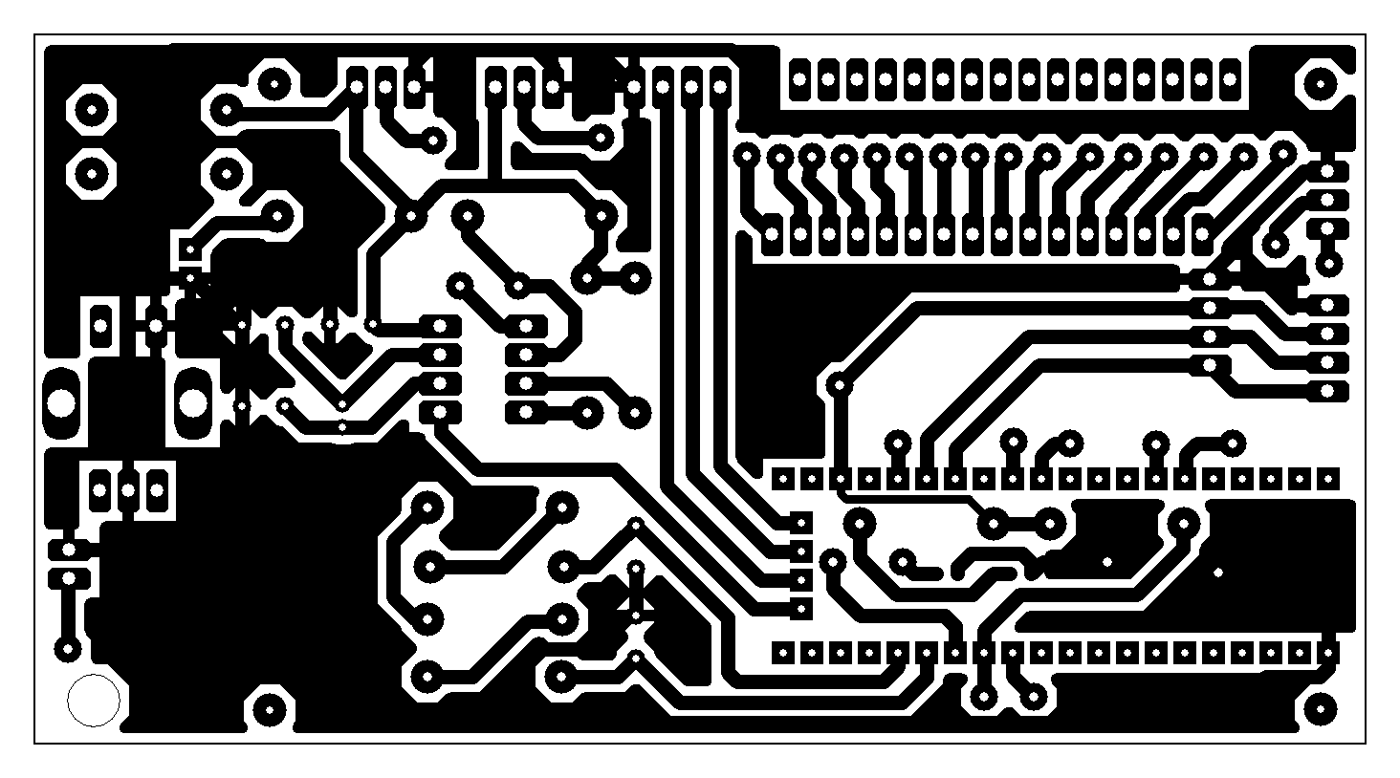
PCB Design/Exported Schematics/HWV1.0/PCB_ST_TOP_MIRROR.BMP
