cristobalgc/STM32_PID_CONTROLLER/Bill of Materials/BOM.xlsx

Bill Of Materials for PCB_ST
Design Title |  |  | PCB_ST
Author
Document Number
Revision
Design Created |  |  | miércoles, 11 de marzo de 2015
Design Last Modified |  |  | domingo, 13 de febrero de 2022
Total Parts In Design |  |  | 30
 |  |  |  |  |  | Totals
Category | Quantity | References | Value | Stock Code | Unit Cost | Category | Quantity | Unit Cost
Capacitors | 2 | C1-C2 | 6pF | Digikey 399-1053-1-ND | €0,35 | Modules | 0 | 0
Capacitors | 1 | C3 | 1.0u | Digikey 478-1409-2-ND | €0,35 | Capacitors | 6 | 2.75
Capacitors | 2 | C4-C5 | 10n | Digikey 399-1053-1-ND | €0,35 | Resistors | 10 | 1.5
Capacitors | 1 | C6 | 100n | Digikey 399-1053-1-ND | €1,00 | Integrated Circuits | 4 | 8
Resistors | 1 | R1 | 1k | M1k | €0,15 | Transistors | 0 | 0
Resistors | 9 | R2-R10 | 10k | M10K | €0,15 | Diodes | 0 | 0
Integrated Circuits | 1 | U1 | STM32F103 |  | €3,50 | Miscellaneous | 10 | 9.95
Integrated Circuits | 1 | U2 | 74HC14 |  | €1,00 | Total | 30 | 22.2
Integrated Circuits | 1 | U3 | PCF8574 |  | €2,50
Integrated Circuits | 1 | U6 | DS1302 |  | €1,00
Miscellaneous | 2 | ADC,UART | CONN-SIL3 |  | €0,40
Miscellaneous | 1 | BATT | CONN-H2 |  | €0,35
Miscellaneous | 2 | IIC,JTAG | CONN-H4 |  | €0,40
Miscellaneous | 1 | L1 |  |  | €0,25
Miscellaneous | 1 | LCD_20X4 | CONN-H16 |  | €4,50
Miscellaneous | 1 | PWM | CONN-SIL5 |  | €0,25
Miscellaneous | 1 | RENC1 | ROTARY_ENCODER1 |  | €2,50
Miscellaneous | 1 | X1 | CRYSTAL |  | €0,50
