cristobalgc/STM32_PID_CONTROLLER/PCB Design/Proteus3dCAD/LCD20x4.dxf

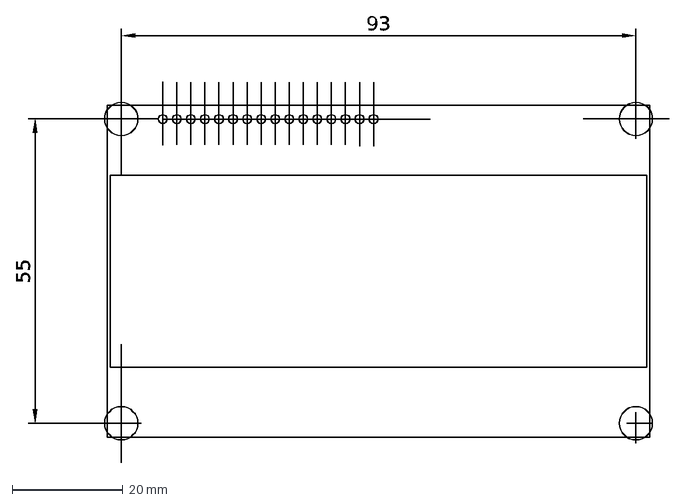
[picture p21: CAD file, 2022-02-13]
PCB Design/Proteus3dCAD/LCD20x4.dxf
55
93
