cristobalgc/STM32_PID_CONTROLLER/PCB Design/Proteus3dCAD/EC11E12-15P30C-SW.stp

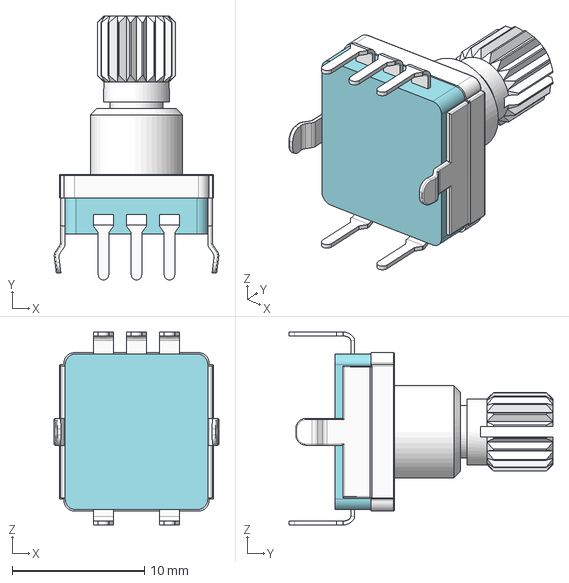
[picture p22: CAD file, 2021-04-18]
PCB Design/Proteus3dCAD/EC11E12-15P30C-SW.stp
12.5 x 20.0 x 14.6 mm
