cristobalgc/STM32_PID_CONTROLLER/PCB Design/Proteus3dCAD/XH2.54 3p.stp

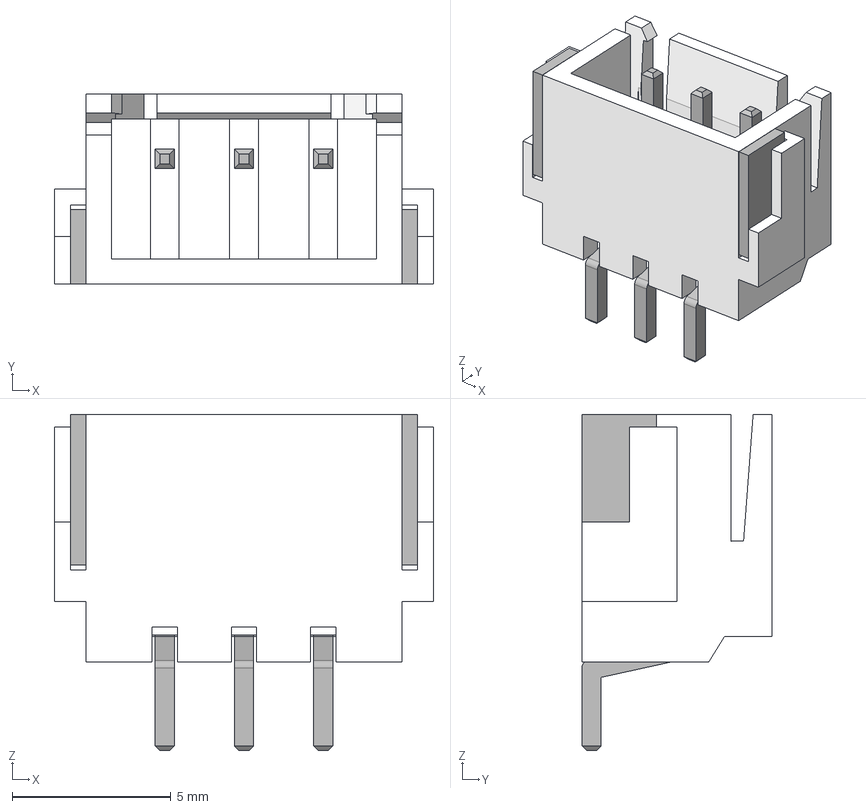
[picture p23: CAD file, 2021-04-18]
PCB Design/Proteus3dCAD/XH2.54 3p.stp
11.9 x 6.00 x 10.6 mm
