cristobalgc/STM32_PID_CONTROLLER/PCB Design/Proteus3dCAD/STM32F103C8T6_Blue_Pill.stp

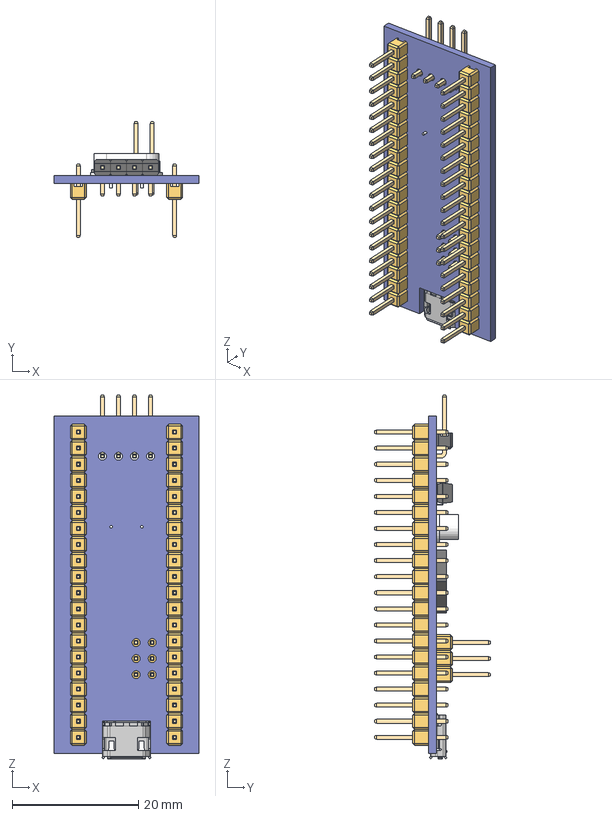
[picture p24: CAD file, 2021-04-18]
PCB Design/Proteus3dCAD/STM32F103C8T6_Blue_Pill.stp
22.9 x 18.3 x 57.6 mm
Oscillator_HC-49/S
STM32F103C8T6_BluePill_Board
Oscillator_MC-306
STM32_LQFP48
Tactile_SMD_5x5mm
Header_L4_10x4.8
Header_Male_2x3x11.6
Header_Male_1x20x11.6 x 2
