cristobalgc/STM32_PID_CONTROLLER/(list of files, cad)

Other CAD files:
Schematic CAD/PLANOS.dwg
