cristobalgc/STM32_PID_CONTROLLER/PCB Design/Exported Schematics/HW1.0.0/PCB_PID_Schematic_HW1.0.0.pdf

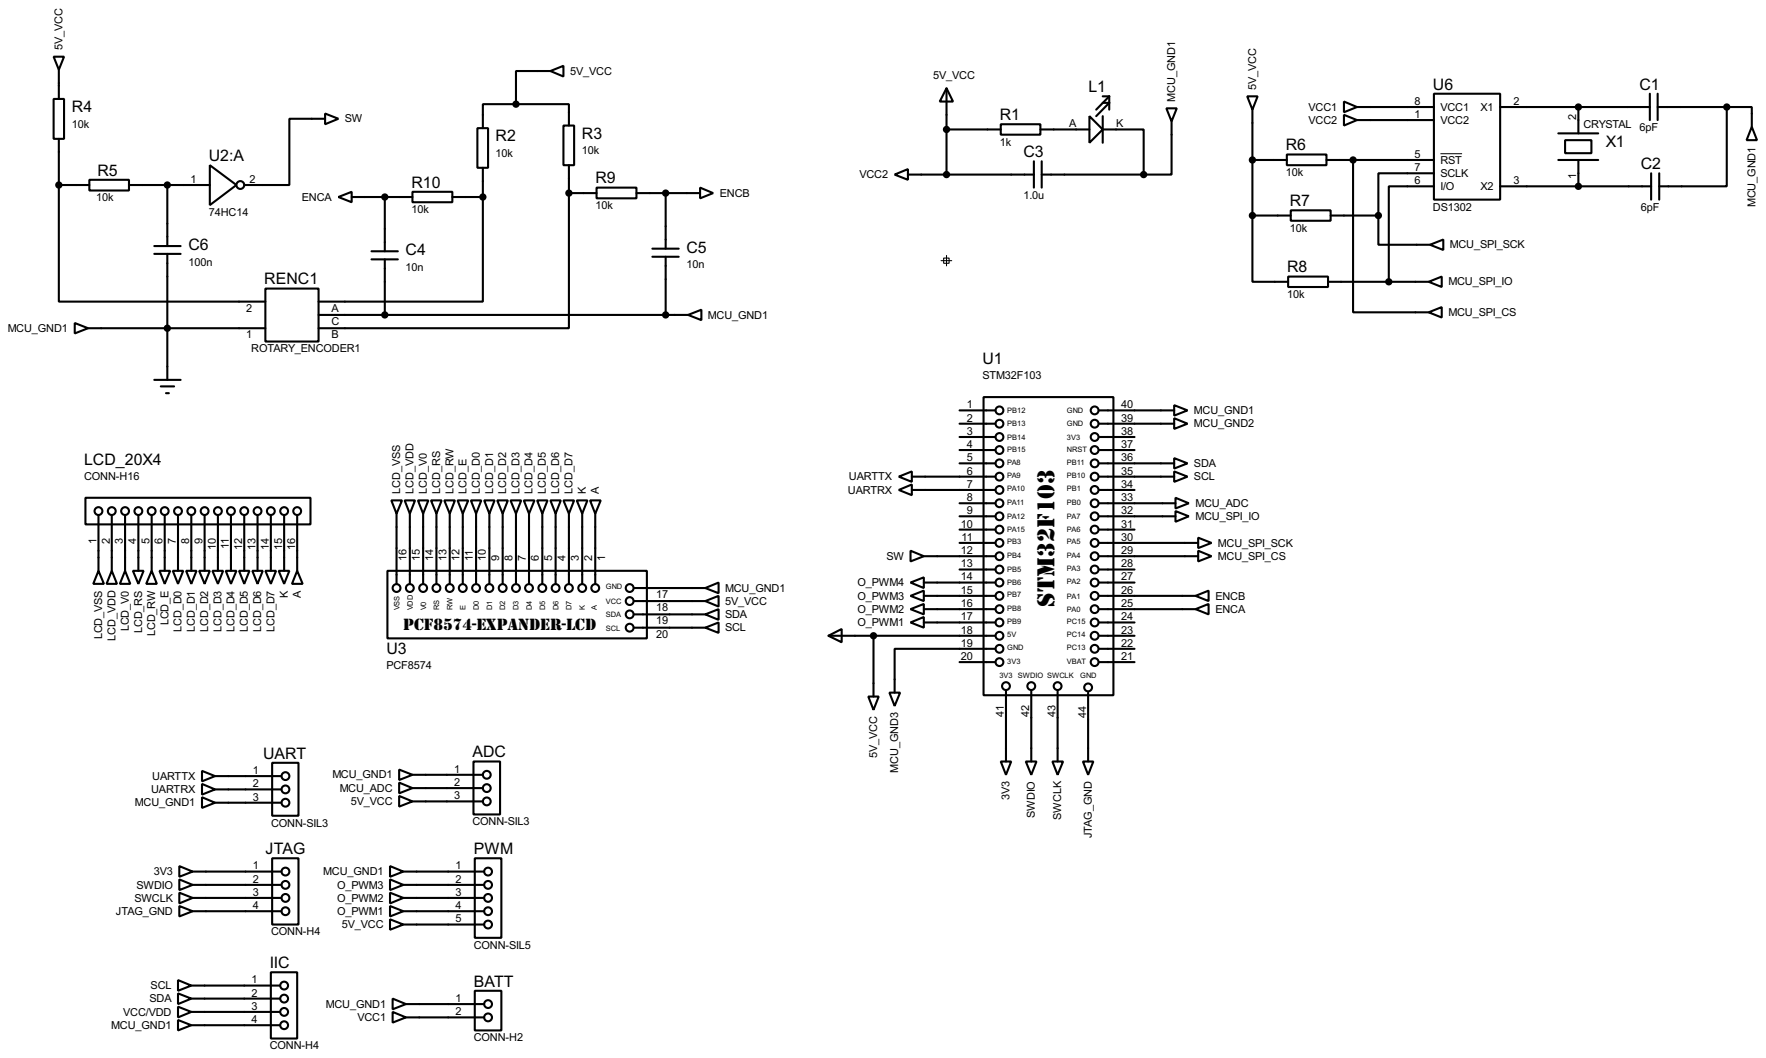
[picture p25: page 1]

12345678910111213141516 LCD_20X4 CONN-H16 CB 2 A 1 RENC1 ROTARY_ENCODER1 R2 10k R3 10k R4 10k PB12 PB13 PB14 PB15 PA8 PA9 PA10 PA11 PA12 PA15 PB3 PB4 PB5 PB6 PB7 PB8 PB9 5V GND GND 3V3 NRST PB11 PB10 PB1 PB0 PA7 PA6 PA5 PA4 PA3 PA2 PA1 PA0 PC15 PC14 PC13 VBAT GND 3V3 3V3 SWDIO SWCLK GND STM32F103 1234 40393837 5 36 6 35 7 34 8 33 9 32 10 31 11 30 12 29 13 28 14 27 15 26 16 25 17 24 18 23 19 22 20 21 41434244 U1 STM32F103 ENCA ENCB SW SW MCU_GND1 MCU_GND1 ENCB MCU_GND3 5V_VCC MCU_GND2 123 UART CONN-SIL3 MCU_GND1 UARTRX UARTTX UARTTX UARTRX 1234 JTAG CONN-H4 3V3 SWDIO SWCLK JTAG_GND 3V3 SWDIO SWCLK JTAG_GND RST 5 SCLK 7 I/O 6 X1 2 X2 3 VCC1 8 VCC2 1 U6 DS1302 1 2 X1 CRYSTAL C1 6pF C2 6pF 5V_VCC C3 1.0u R1 1k VCC2 VCC2 VCC1 R6 10kR7 10k R8 10k O_PWM4 O_PWM3 MCU_SPI_SCK MCU_SPI_IO LCD_VSS LCD_VDD LCD_V0 LCD_E LCD_D0 LCD_D1 LCD_D2 LCD_D3 LCD_D4 LCD_RS LCD_D5 LCD_D6 LCD_D7K LCD_RWA LKACD_D7 LCD_D6 LCD_D5 LCD_D4 LCD_D3 LCD_D2 LCD_D1 LCD_D0 LCD_E LCD_RW LCD_RS LCD_V0 LCD_VDD LCD_VSS MCU_GND1 5V_VCC SDA SCL DKA7D6D5D4D3D2D1D0REWRSV0VDD VSS GND VCC SDA PCF8574-EXPANDER-LCD SCL 20191817 19876543210111213141516 U3 PCF8574 MCU_GND1 5V_VCC 123 ADC CONN-SIL3 MCU_GND1 MCU_ADC 5V_VCC 5V_VCC 5V_VCC MCU_GND1 MCU_GND1 R9 10k R10 10k ENCA C4 10n C5 10n MCU_ADC A K L1 O_PWM2 MCU_SPI_CS 1234 IICCONN-H4 SCL SDA VCC/VDD MCU_GND1 MCU_SPI_CS MCU_SPI_SCK MCU_SPI_IO SCL SDA O_PWM1 12345 PWM CONN-SIL5 MCU_GND1 O_PWM3 O_PWM2 O_PWM1 5V_VCC 12 BATT CONN-H2 MCU_GND1 VCC1 R5 10k C6 100n 1 2 U2:A 74HC14
