cristobalgc/STM32_PID_CONTROLLER/PCB Design/Exported Schematics/HW1.0.0/Bottom_Mirror_HW1.0.0.pdf

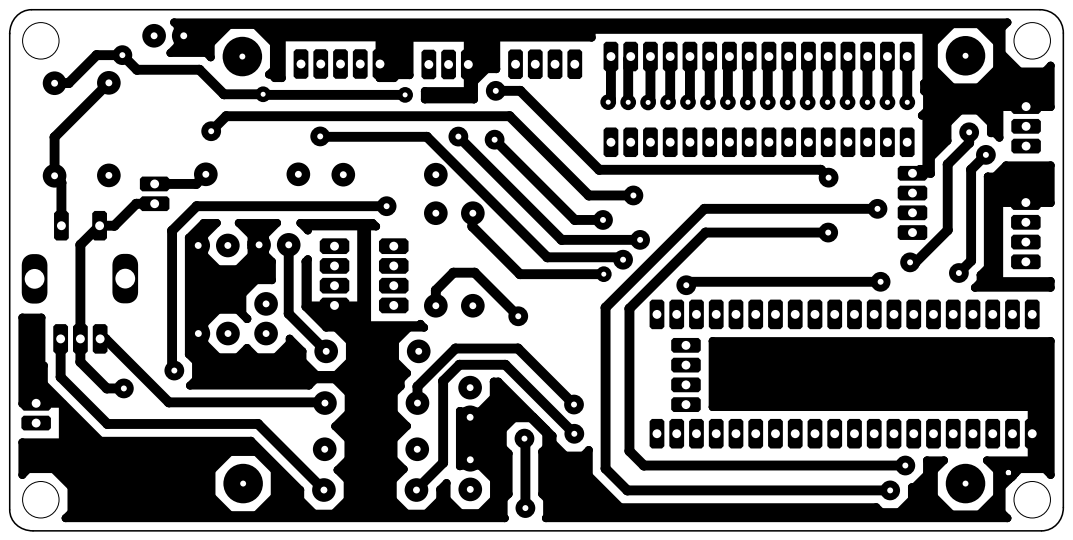
[picture p27: page 1]
