cristobalgc/STM32_PID_CONTROLLER/PCB Design/Exported Schematics/HW1.0.0/Bottom_Normal_HW1.0.0.pdf

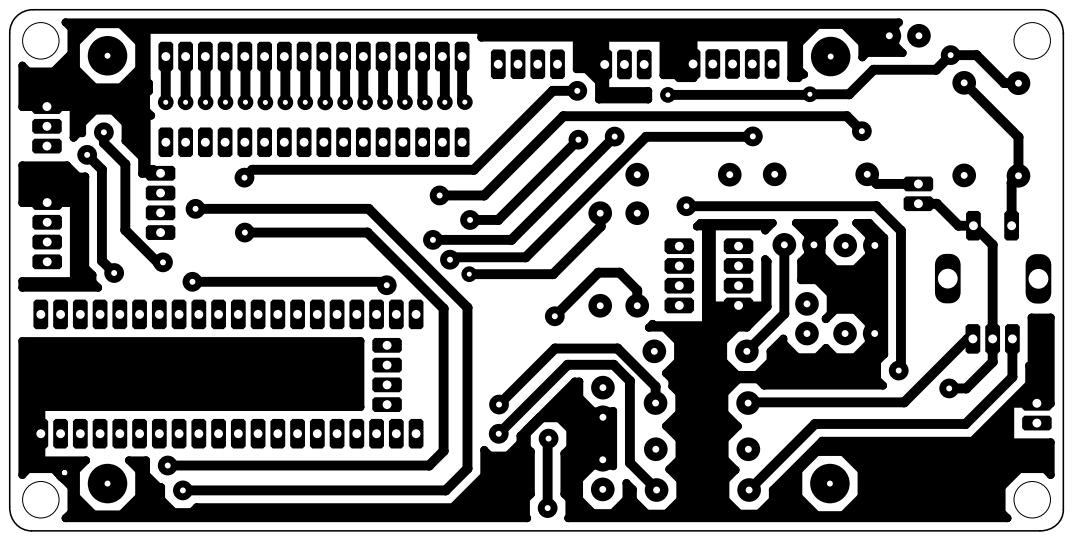
[picture p28: page 1]
