cristobalgc/STM32_PID_CONTROLLER/PCB Design/Exported Schematics/HW1.0.0/Top_Mirror_HW1.0.0.pdf

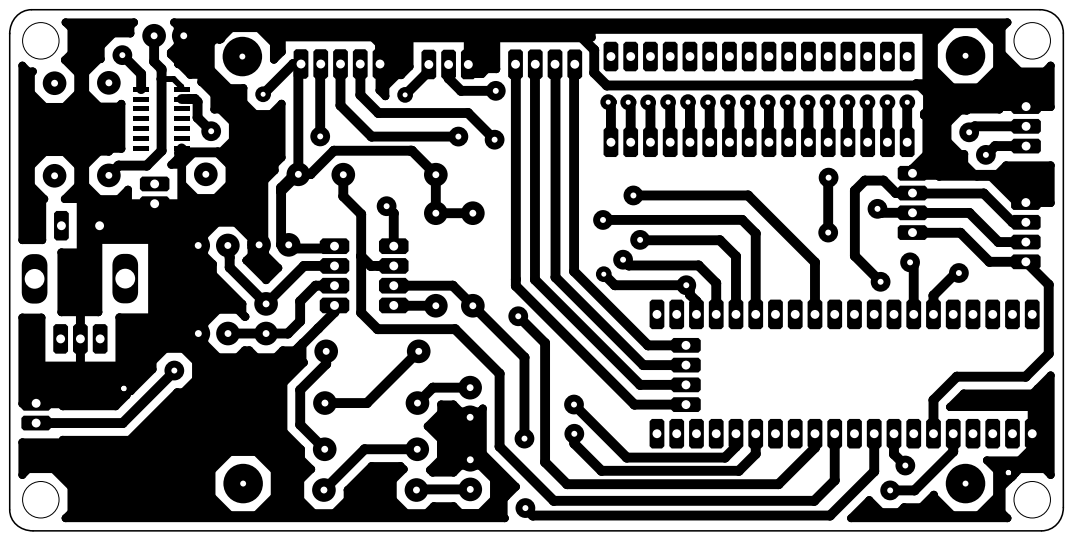
[picture p29: page 1]
