cristobalgc/STM32_PID_CONTROLLER/PCB Design/Exported Schematics/HW1.0.0/Top_Normal_HW1.0.0.pdf

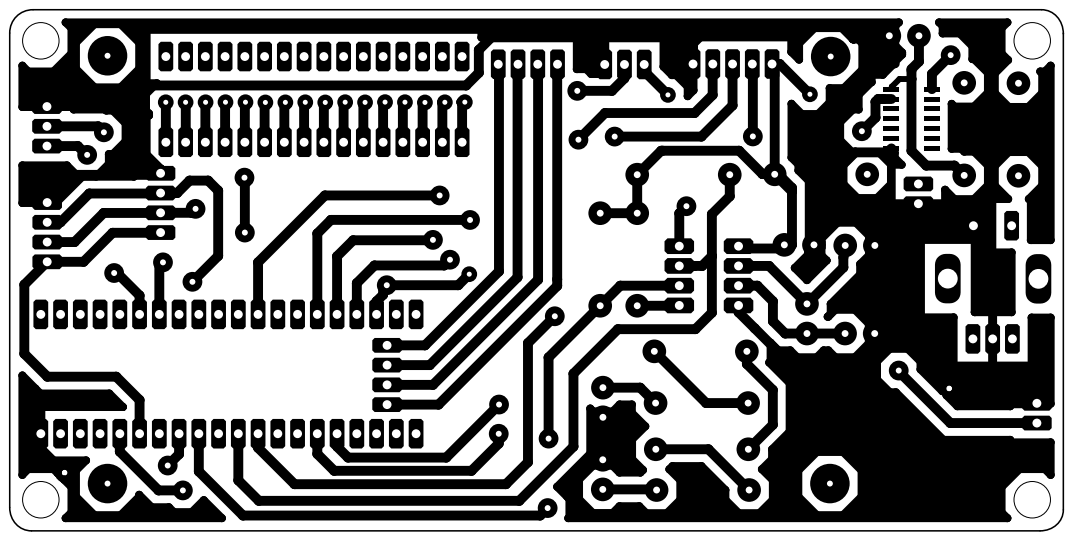
[picture p30: page 1]
