cristobalgc/STM32_PID_CONTROLLER/Doc/Planos/FOTOLITO_PCB_PARTE_TRASERA.pdf

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

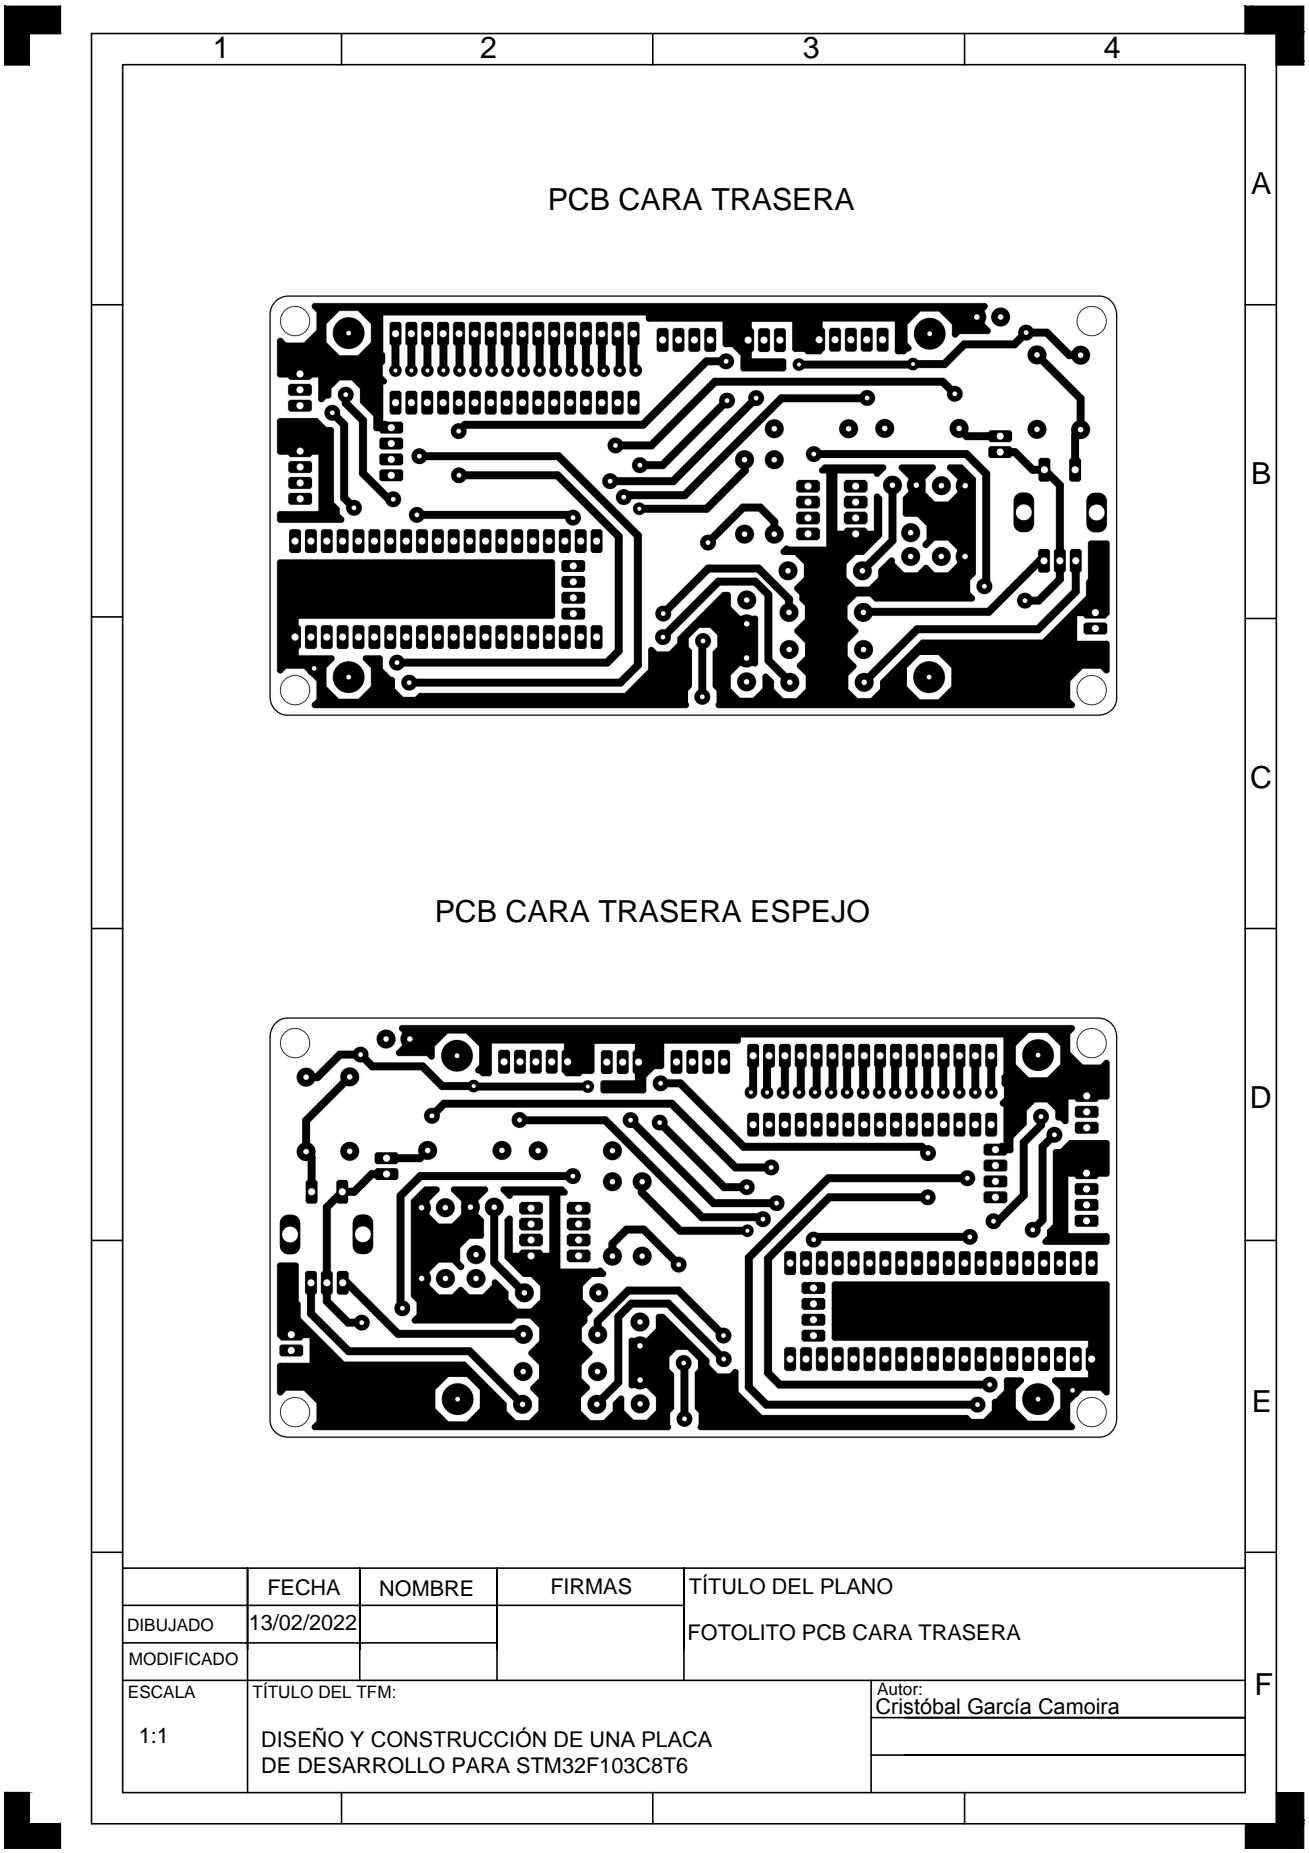
[picture p32: page 1]
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
