cristobalgc/STM32_PID_CONTROLLER/(list of files, drawings)

Other design files:
PCB Design/PCB_ST.pdsprj
