cristobalgc/STM32_PID_CONTROLLER/PID_Regulator/Src/main.c

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

/* Includes ------------------------------------------------------------------*/
#include "main.h"

/* USER CODE BEGIN Includes */
#include <string.h>
#include "stm32f1xx_hal.h"
#include <../ds1302/ds1302.h>
#include <../menu/menu.h>
#include "../pid/pid.h"

#include "../lcd/bigFont_lcdI2c.h"
#include "../lcd/lcd_Hd44780I2C.h"

#include "../sdbg/sdbg.h"
/* USER CODE END Includes */

/* USER CODE BEGIN PD */

#define LCD_ROWS		(4U)
#define LCD_COLS		(20U)
#define LCD_I2C_ADDRESS	(0x4E)

#define SAMPLING_TIME (2U)

#define KP_ENTIRE 	(7U)
#define KP_DECIMAL	(0U)
#define KI_ENTIRE 	(0U)
#define KI_DECIMAL 	(100U)
#define KD_ENTIRE 	(0U)
#define KD_DECIMAL 	(10U)

#define AD_RESOLLUTION 		(5000000/4096)
#define DEFAULT_DUTY_VAL 	(500u)
#define SET_POINT_INIT_VAL 	(4217u)
#define SET_POINT_DECIMAL 	(0u)


#define HOUR_FORMAT	(0) // 0 = 0-24h; 1= 0-12h
#define HOUR 		(13U)
#define MINUTES 	(18U)
#define SECONDS 	(00U)
#define AM_PM		(1U)
#define WEEKDAY 	(1U)
#define MONTHDAY 	(14U)
#define MONTH 		(8U)
#define YEAR 		(2022U)

#define HOUR_ALARM_FORMAT	(0U) // 0 = 0-24h; 1= 0-12h
#define HOUR_ALARM			(15U)
#define MINUTES_ALARM		(10U)
#define SECONDS_ALARM		(10U)
#define AM_PM_ALARM			(1U)
#define ALARM_STATUS		(0U)// OFF

#define ADC_BUFFER_LEN	(1U)

/* USER CODE END PD */

/* USER CODE BEGIN PM */

/* Exported functions ------------------------------------------------------- */
/* USER CODE END PM */

ADC_HandleTypeDef hadc1;
DMA_HandleTypeDef hdma_adc1;

I2C_HandleTypeDef hi2c2;

SPI_HandleTypeDef hspi1;

TIM_HandleTypeDef htim1;
TIM_HandleTypeDef htim2;
TIM_HandleTypeDef htim3;
TIM_HandleTypeDef htim4;

UART_HandleTypeDef huart1;
DMA_HandleTypeDef hdma_usart1_tx;
DMA_HandleTypeDef hdma_usart1_rx;

/* USER CODE BEGIN PV */

/* Lcd object */
static LCD_t Lcd;
/* PID object */
static pidc_t Pid;
/* DS1302 object */
static ds1302_T rtc;
/* Menu object */
static menu_T menu;

static uint8_t flag_timer1 = 0u;

/*Pid configuration */
static const pid_cfg_t pidcfg = {
		KP_ENTIRE,
		KP_DECIMAL,
		KI_ENTIRE,
		KI_DECIMAL,
		KD_ENTIRE,
		KD_DECIMAL,
		AD_RESOLLUTION,
		SAMPLING_TIME,
		DEFAULT_DUTY_VAL,
		SET_POINT_INIT_VAL
};

/* Pid configuration for menu */
static const menu_pidCfg_t menuPidCfg = {
		KP_ENTIRE,
		KP_DECIMAL,
		KI_ENTIRE,
		KI_DECIMAL,
		KD_ENTIRE,
		KD_DECIMAL,
		SET_POINT_INIT_VAL,
		SET_POINT_DECIMAL
};

/* Clock configuration for menu */
static const menu_dateTimeCfg_t menu_dateTimeCfg ={
		HOUR_FORMAT, HOUR, MINUTES, SECONDS, AM_PM, WEEKDAY, MONTHDAY, MONTH, YEAR
};

/* Clock configuration for menu */
static const menu_alarmCfg_t menu_alarmCfg ={
		HOUR_ALARM_FORMAT, HOUR_ALARM, MINUTES_ALARM, SECONDS_ALARM, AM_PM_ALARM, ALARM_STATUS
};

/*Lcd configuration */
static const LCD_cfg_t Lcd_Hd44780I2cCfg =
{
	&hi2c2,   /* Depending on your active I2C configuration */
	LCD_COLS, /* Lcd columns */
	LCD_ROWS, /* Lcd rows */
	LCD_I2C_ADDRESS, /* Lcd address. Depending on your PCF8574T expander board it could change. */
	LCD_5x8DOTS /* Pending to remove, here you can set 0*/
};

static ds1302_cfg_T ds1302_config = {
	&hspi1,
	{GPIOA, GPIO_PIN_4}
};

static const menu_item_T menu1_cfg_options[6]={
        {0, menu_op1, menu_op1_sel, MENU_PidSelected},
		{1, menu_op2, menu_op2_sel, MENU_HourSelected},
		{2, menu_op3, menu_op3_sel, MENU_enterPidOptions},
		{3, menu_op4, menu_op4_sel, MENU_enterClockOptions},//
		{4, menu_op5, menu_op5_sel, MENU_ChangePwmSelected},
		{5, menu_Exit, menu_Exit_sel, MENU_ExitSelected},
};

/* MENU screen config */
static const menu_cfg_T menu1_cfg = {
		MENU_MAIN,
		MENU_SCREEN_NO_FREEZE,
		4,//max lines
		0,//line start
		5,//max options
		0,//min menu start option
		&menu1_cfg_options[0]
};

static const menu_item_T menu_defaultHourOptions[4]={
		{0, menu_empty, menu_empty, MENU_defaultHourToMainSel},
		{1, menu_empty, menu_empty, MENU_defaultHourToMainSel},
		{2, menu_empty, menu_empty, MENU_defaultHourToMainSel},
		{3, menu_empty, menu_empty, MENU_defaultHourToMainSel},
};

/* HOUR screen config */
static const menu_cfg_T menu_defaultHour = {
		MENU_DEFAULT_HOUR,
		MENU_SCREEN_NO_FREEZE,
		4,//max lines
		0,//line start
		0,//max options
		0,//min menu start option
		&menu_defaultHourOptions[0]
};

static const menu_item_T menu_defaultPidOptions[4]={
		{0, menu_defLine1Pid, menu_defLine1Pid, MENU_defaultPidToMainSel},
		{1, menu_defLine2Pid, menu_defLine2Pid, MENU_defaultPidToMainSel},
		{2, menu_defLine3Pid, menu_defLine3Pid, MENU_defaultPidToMainSel},
		{3, menu_defLine4Pid, menu_defLine4Pid, MENU_defaultPidToMainSel},
};

/* Pid screen config for PID*/
static const menu_cfg_T menu_defaultPid = {
		MENU_DEFAULT_PID,
		MENU_SCREEN_NO_FREEZE,
		4,
		0,
		0,
		0,
		&menu_defaultPidOptions[0]
};

static const menu_item_T menu_ChangePidSettingsOptions[11]={
		{0, submenu1_op1, submenu1_op1, NULL},
		{1, menu_empty, submenu1_op2, MENU_ChangeKpEntireSel},
		{2, menu_empty, submenu1_op3, MENU_ChangeKpDecimalSel},
		{3, menu_empty, submenu1_op4, MENU_ChangeKiEntireSel},
		{4, menu_empty, submenu1_op5, MENU_ChangeKiDecimalSel},
		{5, menu_empty, submenu1_op6, MENU_ChangeKdEntireSel},
		{6, menu_empty, submenu1_op7, MENU_ChangeKdDecimalSel},
		{7, menu_empty, submenu1_op8, MENU_ChangeSetPointEntireSel},
		{8, menu_empty, submenu1_op9, MENU_ChangeSetPointDecimalSel},
		{9, menu_empty, submenu1_op10, MENU_ExitAndSavePid},
		{10, menu_empty, submenu1_op11, MENU_exitAndNoSavePid},
};

/* Screen to Change PID settings*/
static const menu_cfg_T menu_ChangePidSettings = {
		MENU_PID_SETTINGS,
		MENU_SCREEN_NO_FREEZE,
		1, // Used Lines to print the menu
		1, // Print the entire menu rotating on this line
		10,// number of menu items
		1, //min menu start option
		&menu_ChangePidSettingsOptions[0]
};

static const menu_item_T menu_ChangeDateTimeOptions[12]={
		{0, submenu3_op1, submenu3_op1, NULL},
		{1, menu_empty, submenu3_op2, MENU_ChangeHourFormatSel},
		{2, menu_empty, submenu3_op6, MENU_ChangeAmPmSel},
		{3, menu_empty, submenu3_op3, MENU_ChangeHourSel},
		{4, menu_empty, submenu3_op4, MENU_ChangeMinSel},
		{5, menu_empty, submenu3_op5, MENU_ChangeSecSel},
		{6, menu_empty, submenu3_op7, MENU_ChangeWeekDaySel},
		{7, menu_empty, submenu3_op8, MENU_ChangeMonthDaySel},
		{8, menu_empty, submenu3_op9, MENU_ChangeMonthSel},
		{9, menu_empty, submenu3_op10, MENU_ChangeYearSel},
		{10, menu_empty, submenu3_op11, MENU_exitAndSaveDateTime},
		{11, menu_empty, submenu3_op12, MENU_exitAndNoSaveDateTime},
};

/* Screen to Change Hours*/
static const menu_cfg_T menu_ChangeDateTime = {
		MENU_CLOCK_SETTINGS,
		MENU_SCREEN_NO_FREEZE,
		1, // Used Lines to print the menu
		1, // Print the entire menu rotating on this line
		11,// number of menu items
		1, //min menu start option
		&menu_ChangeDateTimeOptions[0]
};

static const menu_item_T menu_changeHourFormatOptions[1]={
		{0, menu_empty, menu_empty, MENU_exitChangeClockSelected},
};

/* Screen to Change Hour format */
static const menu_cfg_T menu_changeHourFormat = {
		MENU_CHANGE_HOUR_FORMAT,
		MENU_SCREEN_FREEZE,
		1, // Used Lines to print the menu
		1, // Print the entire menu rotating on this line
		1,// number of menu items
		0, //min menu start option
		&menu_changeHourFormatOptions[0]
};

static const menu_item_T menu_changeHourAmPmOptions[1]={
		{0, menu_empty, menu_empty, MENU_exitChangeClockSelected},
};

/* Screen to Change Hour mode */
static const  menu_cfg_T menu_changeHourAmPm = {
		MENU_CHANGE_HOUR_AM_PM,
		MENU_SCREEN_FREEZE,
		1, // Used Lines to print the menu
		1, // Print the entire menu rotating on this line
		1,// number of menu items
		0, //min menu start option
		&menu_changeHourAmPmOptions[0]
};

static const menu_item_T menu_changeHoursOptions[1]={
		{0, menu_empty, menu_empty, MENU_exitChangeClockSelected},
};

/* Screen to Change Hours */
static const menu_cfg_T menu_changeHours = {
		MENU_CHANGE_HOUR,
		MENU_SCREEN_FREEZE,
		1, // Used Lines to print the menu
		1, // Print the entire menu rotating on this line
		23,// number of menu items
		0, //min menu start option
		&menu_changeHoursOptions[0]
};

static const menu_item_T menu_changeMinutesOptions[1]={
		{0, menu_empty, menu_empty, MENU_exitChangeClockSelected},
};

/* Screen to Change Minutes */
static const menu_cfg_T menu_changeMinutes = {
		MENU_CHANGE_MINUTES,
		MENU_SCREEN_FREEZE,
		1, // Used Lines to print the menu
		1, // Print the entire menu rotating on this line
		59,// number of menu items
		0, //min menu start option
		&menu_changeMinutesOptions[0]
};


static const menu_item_T menu_changeSecondsOptions[1]={
		{0, menu_empty, menu_empty, MENU_exitChangeClockSelected},
};


/* Screen to Change Seconds */
static const menu_cfg_T menu_changeSeconds = {
		MENU_CHANGE_SECONDS,
		MENU_SCREEN_FREEZE,
		1, // Used Lines to print the menu
		1, // Print the entire menu rotating on this line
		59,// number of menu items
		0, //min menu start option
		&menu_changeSecondsOptions[0]
};

static const menu_item_T menu_changeWeekDayOptions[1]={
		{0, menu_empty, menu_empty, MENU_exitChangeClockSelected},
};

/* Screen to Change the day of the week */
static const menu_cfg_T menu_changeWeekDay = {
		MENU_CHANGE_WEEKDAY,
		MENU_SCREEN_FREEZE,
		1, // Used Lines to print the menu
		1, // Print the entire menu rotating on this line
		7, // number of menu items
		1, //min menu start option
		&menu_changeWeekDayOptions[0]
};

static const menu_item_T menu_changeMonthDayOptions[1]= {
		{0, menu_empty, menu_empty, MENU_exitChangeClockSelected},
};


/* Screen to Change the day of the current month*/
static const menu_cfg_T menu_changeMonthDay = {
		MENU_CHANGE_MONTHDAY,
		MENU_SCREEN_FREEZE,
		1, // Used Lines to print the menu
		1, // Print the entire menu rotating on this line
		31,// number of menu items
		1, //min menu start option
		&menu_changeMonthDayOptions[0]
};

static const menu_item_T menu_changeMonthOptions[1]={
		{0, menu_empty, menu_empty, MENU_exitChangeClockSelected},
};

/* Screen to Change the day of the current month*/
static const menu_cfg_T menu_changeMonth = {
		MENU_CHANGE_MONTH,
		MENU_SCREEN_FREEZE,
		1, // Used Lines to print the menu
		1, // Print the entire menu rotating on this line
		12,// number of menu items
		1, //min menu start option
		&menu_changeMonthOptions[0]
};

static const menu_item_T menu_changeYearOptions[1]={
	{0, menu_empty, menu_empty, MENU_exitChangeClockSelected},
};

/* Screen to Change the day of the current month*/
static const menu_cfg_T menu_changeYear = {
		MENU_CHANGE_YEAR,
		MENU_SCREEN_FREEZE,
		1, // Used Lines to print the menu
		1, // Print the entire menu rotating on this line
		999,// number of menu items
		0, //min menu start option
		&menu_changeYearOptions[0]
};

static const menu_item_T menu_changeKpEntireOptions[1]={
		{0, menu_empty, menu_empty, MENU_exitChangePidSelected},
};

/* Screen to Change the Entire part of the KP_ENTIRE parameter*/
static const menu_cfg_T menu_changeKpEntire = {
		MENU_CHANGE_KP_ENTIRE,
		MENU_SCREEN_FREEZE,
		1, // Used Lines to print the menu
		1, // Print the entire menu rotating on this line
		9999,// number of menu items
		0, //min menu start option
		&menu_changeKpEntireOptions[0]
};

static const menu_item_T menu_changeKpDecimalOptions[1]={
		{0, menu_empty, menu_empty, MENU_exitChangePidSelected},
};

/* Screen to Change the decimal part of the KP_ENTIRE parameter*/
static const menu_cfg_T menu_changeKpDecimal = {
		MENU_CHANGE_KP_DECIMAL,
		MENU_SCREEN_FREEZE,
		1, // Used Lines to print the menu
		1, // Print the entire menu rotating on this line
		999,// number of menu items
		0, //min menu start option
		&menu_changeKpDecimalOptions[0]
};

static const menu_item_T menu_changeKiEntireOptions[1]={
		{0, menu_empty, menu_empty, MENU_exitChangePidSelected},
};

/* Screen to Change the Entire part of the KP_ENTIRE parameter*/
static const menu_cfg_T menu_changeKiEntire = {
		MENU_CHANGE_KI_ENTIRE,
		MENU_SCREEN_FREEZE,
		1, // Used Lines to print the menu
		1, // Print the entire menu rotating on this line
		9999,// number of menu items
		0, //min menu start option
		&menu_changeKiEntireOptions[0]
};

static const menu_item_T menu_changeKiDecimalOptions[1]={
		{0, menu_empty, menu_empty, MENU_exitChangePidSelected},
};

/* Screen to Change the decimal part of the KP_ENTIRE parameter*/
static menu_cfg_T menu_changeKiDecimal = {
		MENU_CHANGE_KI_DECIMAL,
		MENU_SCREEN_FREEZE,
		1, // Used Lines to print the menu
		1, // Print the entire menu rotating on this line
		999,// number of menu items
		0, //min menu start option
		&menu_changeKiDecimalOptions[0]
};

static const menu_item_T menu_changeKdEntireOptions[1]=		{
		{0, menu_empty, menu_empty, MENU_exitChangePidSelected},
};

/* Screen to Change the Entire part of the KP_ENTIRE parameter*/
static const menu_cfg_T menu_changeKdEntire = {
		MENU_CHANGE_KD_ENTIRE,
		MENU_SCREEN_FREEZE,
		1, // Used Lines to print the menu
		1, // Print the entire menu rotating on this line
		9999,// number of menu items
		0, //min menu start option
		&menu_changeKdEntireOptions[0]
};

static const menu_item_T menu_changeKdDecimalOptions[1]=		{
		{0, menu_empty, menu_empty, MENU_exitChangePidSelected},
};

/* Screen to Change the decimal part of the KP_ENTIRE parameter*/
static const menu_cfg_T menu_changeKdDecimal = {
		MENU_CHANGE_KD_DECIMAL,
		MENU_SCREEN_FREEZE,
		1, // Used Lines to print the menu
		1, // Print the entire menu rotating on this line
		999,// number of menu items
		0, //min menu start option
		&menu_changeKdDecimalOptions[0]
};

static const menu_item_T menu_changeSetPointEntireOptions[1]={
		{0, menu_empty, menu_empty, MENU_exitChangePidSelected},
};
/* Screen to Change the Entire part of the KP_ENTIRE parameter*/
static const menu_cfg_T menu_changeSetPointEntire = {
		MENU_CHANGE_SET_POINT_ENTIRE,
		MENU_SCREEN_FREEZE,
		1, // Used Lines to print the menu
		1, // Print the entire menu rotating on this line
		9999,// number of menu items
		0, //min menu start option
		&menu_changeSetPointEntireOptions[0]
};

static const menu_item_T menu_changeSetPointDecimalOptions[1]={
		{0, menu_empty, menu_empty, MENU_exitChangePidSelected},
};

/* Screen to Change the decimal part of the KP_ENTIRE parameter*/
static const menu_cfg_T menu_changeSetPointDecimal = {
		MENU_CHANGE_SET_POINT_DECIMAL,
		MENU_SCREEN_FREEZE,
		1, // Used Lines to print the menu
		1, // Print the entire menu rotating on this line
		999,// number of menu items
		0, //min menu start option
		&menu_changeSetPointDecimalOptions[0]
};

static const menu_item_T menu_PidOptionsOptions[7] ={
		{0, submenu4_title, submenu4_title, NULL},
		{1, submenu4_op1, submenu4_op1_sel , MENU_enterChangePidSelected},
		{2, submenu4_op2, submenu4_op2_sel, MENU_showPidValues},
		{3, menu_Exit, menu_Exit_sel, MENU_pidOptionsExitToMain},
};

/* Screen to show all PID options */
static menu_cfg_T menu_PidOptions = {
		MENU_PID_OPTIONS,
		MENU_SCREEN_NO_FREEZE,
		3, // Used Lines to print the menu
		1, // start printing the menu on this line
		3,// number of menu items
		1, //min menu start option
		&menu_PidOptionsOptions[0]
};

static const menu_item_T menu_clockOptionsOptions[7]=		{
		{0, submenu5_title, submenu5_title, NULL},
		{1, submenu5_op1, submenu5_op1_sel , MENU_enterChangeClockSelected},
		{2, submenu5_op2, submenu5_op2_sel, MENU_enterChangeAlarmSelected},
		{3, menu_Exit, menu_Exit_sel, MENU_pidOptionsExitToMain},
};

/* Screen to show all PID options */
static menu_cfg_T menu_clockOptions = {
		MENU_CLOCK_OPTIONS,
		MENU_SCREEN_NO_FREEZE,
		3, // Used Lines to print the menu
		1, // Print the entire menu rotating on this line
		3,// number of menu items
		1, //min menu start option
		&menu_clockOptionsOptions[0]
};

static const menu_item_T menu_PidValuesOptions[4]={
		{0, submenu3_Kp, submenu3_Kp, MENU_exitAndNoSavePid},
		{1, submenu3_Ki, submenu3_Ki, MENU_exitAndNoSavePid},
		{2, submenu3_Kd, submenu3_Kd, MENU_exitAndNoSavePid},
		{3, submenu3_Sp, submenu3_Sp, MENU_exitAndNoSavePid},
};

/* Screen to show all PID options */
static const menu_cfg_T menu_PidValues = {
		MENU_PID_VALUES,
		MENU_SCREEN_NO_FREEZE,
		4, // Used Lines to print the menu
		0, // Print the entire menu rotating on this line
		3, // number of menu items
		0, //min menu start option
		&menu_PidValuesOptions[0]
};

static const menu_item_T menu_ChangeAlarmOptions[9]={
		{0, submenu6_op1, submenu6_op1, NULL},
		{1, menu_empty, submenu6_op2, MENU_ChangeAlarmHourFormatSel},
		{2, menu_empty, submenu6_op3, MENU_ChangeAlarmAmPmSel},
		{3, menu_empty, submenu6_op4, MENU_ChangeAlarmHourSel},
		{4, menu_empty, submenu6_op5, MENU_ChangeAlarmMinSel},
		{5, menu_empty, submenu6_op6, MENU_ChangeAlarmSecSel},
		{6, menu_empty, submenu6_op7, MENU_ChangeAlarmStatusSel},
		{7, menu_empty, submenu6_op8, MENU_exitAndSaveAlarm},
		{8, menu_empty, submenu6_op9, MENU_exitAndNoSaveAlarm}
};

/* Screen to Change Hours*/
static const menu_cfg_T menu_ChangeAlarm = {
		MENU_ALARM_SETTINGS,
		MENU_SCREEN_NO_FREEZE,
		1, // Used Lines to print the menu
		1, // Print the entire menu rotating on this line
		8,// number of menu items
		1, //min menu start option
		&menu_ChangeAlarmOptions[0]
};

static const menu_item_T menu_changeAlarmHourAmPmOptions[1]={
		{0, menu_empty, menu_empty, MENU_exitChangeAlarmSelected},
};

/* Screen to Change Alarm Hour mode */
static const  menu_cfg_T menu_changeAlarmHourAmPm = {
		MENU_CHANGE_ALARM_HOUR_AM_PM,
		MENU_SCREEN_FREEZE,
		1, // Used Lines to print the menu
		1, // Print the entire menu rotating on this line
		1,// number of menu items
		0, //min menu start option
		&menu_changeAlarmHourAmPmOptions[0]
};

static const menu_item_T menu_changeAlarmHourFormatOptions[1]={
		{0, menu_empty, menu_empty, MENU_exitChangeAlarmSelected},
};

/* Screen to Change Hour format */
static const menu_cfg_T menu_changeAlarmHourFormat = {
		MENU_CHANGE_ALARM_HOUR_FORMAT,
		MENU_SCREEN_FREEZE,
		1, // Used Lines to print the menu
		1, // Print the entire menu rotating on this line
		1,// number of menu items
		0, //min menu start option
		&menu_changeAlarmHourFormatOptions[0]
};

static const menu_item_T menu_changeAlarmHoursOptions[1]={
		{0, menu_empty, menu_empty, MENU_exitChangeAlarmSelected},
};

/* Screen to Change Hours */
static const menu_cfg_T menu_changeAlarmHours = {
		MENU_CHANGE_ALARM_HOUR,
		MENU_SCREEN_FREEZE,
		1, // Used Lines to print the menu
		1, // Print the entire menu rotating on this line
		23,// number of menu items
		0, //min menu start option
		&menu_changeAlarmHoursOptions[0]
};

static const menu_item_T menu_changeAlarmMinutesOptions[1]={
		{0, menu_empty, menu_empty, MENU_exitChangeAlarmSelected},
};

/* Screen to Change Hours */
static const menu_cfg_T menu_changeAlarmMinutes = {
		MENU_CHANGE_ALARM_MINUTES,
		MENU_SCREEN_FREEZE,
		1, // Used Lines to print the menu
		1, // Print the entire menu rotating on this line
		59,// number of menu items
		0, //min menu start option
		&menu_changeAlarmMinutesOptions[0]
};

static const menu_item_T menu_changeAlarmSecondsOptions[1]={
		{0, menu_empty, menu_empty, MENU_exitChangeAlarmSelected},
};

/* Screen to Change Hours */
static const menu_cfg_T menu_changeAlarmSeconds = {
		MENU_CHANGE_ALARM_SECONDS,
		MENU_SCREEN_FREEZE,
		1, // Used Lines to print the menu
		1, // Print the entire menu rotating on this line
		59,// number of menu items
		0, //min menu start option
		&menu_changeAlarmSecondsOptions[0]
};

static const menu_item_T menu_changeAlarmStatusOptions[1]={
		{0, menu_empty, menu_empty, MENU_exitChangeAlarmSelected},
};

/* Screen to Change Hours */
static const menu_cfg_T menu_changeAlarmStatus = {
		MENU_CHANGE_ALARM_STATUS,
		MENU_SCREEN_FREEZE,
		1, // Used Lines to print the menu
		1, // Print the entire menu rotating on this line
		1,// number of menu items
		0, //min menu start option
		&menu_changeAlarmStatusOptions[0]
};

static const menu_cfg_T *menu_configs[33]={
		&menu_defaultPid,			//0
		&menu_defaultPid,			//1
		&menu_defaultHour,			//2
		&menu1_cfg,					//3
		&menu_PidOptions,			//4
		&menu_ChangeDateTime,		//5
		&menu_changeHourFormat,		//6
		&menu_changeHourAmPm,		//7
		&menu_changeHours,			//8
		&menu_changeMinutes,		//9
		&menu_changeSeconds,		//10
		&menu_changeWeekDay,		//11
		&menu_changeMonthDay,		//12
		&menu_changeMonth,			//13
		&menu_changeYear,			//14
		&menu_ChangePidSettings,	//15
		&menu_changeKpEntire,		//16
		&menu_changeKpDecimal,		//17
		&menu_changeKiEntire,		//18
		&menu_changeKiDecimal,		//19
		&menu_changeKdEntire,		//20
		&menu_changeKdDecimal,		//21
		&menu_changeSetPointEntire,	//22
		&menu_changeSetPointDecimal,//23
		&menu_PidValues,			//24
		&menu_clockOptions,			//25
		&menu_ChangeAlarm,			//26
		&menu_changeAlarmHourFormat,//27
		&menu_changeAlarmHourAmPm,  //28
		&menu_changeAlarmHours,		//29
		&menu_changeAlarmMinutes,  //30
		&menu_changeAlarmSeconds,//31
		&menu_changeAlarmStatus,//32
};

static uint32_t i2c_TxInterrupts = 0;
static uint32_t i2c_RxInterrupts = 0;
static uint32_t Uart_TxInterrupts = 0;
uint8_t Rx_indx,Transfer_cplt;
char Rx_data[2],Rx_Buffer[100];
static uint16_t adc_buffer[ADC_BUFFER_LEN];
/* USER CODE END PV */

void SystemClock_Config(void);
static void MX_GPIO_Init(void);
static void MX_TIM2_Init(void);
static void MX_DMA_Init(void);
static void MX_USART1_UART_Init(void);
static void MX_TIM4_Init(void);
static void MX_SPI1_Init(void);
static void MX_ADC1_Init(void);
static void MX_TIM1_Init(void);
static void MX_I2C2_Init(void);
static void MX_TIM3_Init(void);
/* USER CODE BEGIN 0 */

static void print_normal_Menu(void){
	LCD_setCursor(&Lcd, 0, 0);
	LCD_print(&Lcd, "%s", menu.data.lines[0]);
	LCD_setCursor(&Lcd, 0, 1);
	LCD_print(&Lcd, "%s", menu.data.lines[1]);
	LCD_setCursor(&Lcd, 0, 2);
	LCD_print(&Lcd, "%s", menu.data.lines[2]);
	LCD_setCursor(&Lcd, 0, 3);
	LCD_print(&Lcd, "%s", menu.data.lines[3]);
}


static void print_datetime_big_format(void){
	BIGFONT_printChar(&Lcd,':', 7, 0);
	BIGFONT_printNumber(&Lcd, menu.data.hour10, 0, 0);
	BIGFONT_printNumber(&Lcd, menu.data.hour, 4, 0);
	BIGFONT_printNumber(&Lcd, menu.data.minutes10, 10, 0);
	BIGFONT_printNumber(&Lcd, menu.data.minutes, 14, 0);
	LCD_setCursor(&Lcd, 18, 0);
	LCD_print(&Lcd,"%d", menu.data.seconds10);
	LCD_setCursor(&Lcd, 19, 0);
	LCD_print(&Lcd,"%d", menu.data.seconds);
	LCD_setCursor(&Lcd, 0, 3);
	LCD_print(&Lcd, "%s", menu.data.lines[3]);
}


void HAL_TIM_PeriodElapsedCallback(TIM_HandleTypeDef *htim)
{
	menu_status_t menuStatus = MENU_DEFAULT_CFG;

	//check if the interrupt comes from TIM1
	if(htim->Instance == TIM1){
		menuStatus = MENU_GetStatus(&menu);
		HAL_GPIO_TogglePin(GPIOC, GPIO_PIN_13);
		if ((menuStatus == MENU_DEFAULT_PID)){
			MENU_Task(&menu);
			print_normal_Menu();
		}else if((menuStatus == MENU_DEFAULT_HOUR)){
			//LCD_clear(&Lcd_2);
			MENU_Task(&menu);
			print_datetime_big_format();
		}else{
			/* Nothing to do */
		}
		flag_timer1 = 1u;
	}
}

void HAL_ADC_ConvCpltCallback(ADC_HandleTypeDef* hadc){
	if(hadc->Instance == ADC1){
		PID_control(&Pid, adc_buffer[0]);
		MENU_SetAdcValue(&menu, PID_GetAdcValule(&Pid));
		MENU_SetDutyCycle(&menu, PID_GetDutyValule(&Pid));
	}
}

void HAL_TIM_IC_CaptureCallback(TIM_HandleTypeDef *htim)
{
	menu_status_t menuStatus = MENU_DEFAULT_CFG;

	if (htim->Instance == TIM2) //check if the interrupt comes from TIM2
	{
		if(HAL_TIM_Encoder_GetState(&htim2) == HAL_TIM_STATE_READY)
		{
			menuStatus = MENU_GetStatus(&menu);
			SDBG_print(&huart1,"\r\nEncoder: %d", TIM2->CNT);
			MENU_encoderOption (&menu, (int32_t)TIM2->CNT);

			if (( menuStatus!= MENU_DEFAULT_HOUR) && (menuStatus != MENU_DEFAULT_PID)){
				MENU_Task(&menu);
				print_normal_Menu();
			}
		}
	}
}

void HAL_I2C_MasterTxCpltCallback(I2C_HandleTypeDef *hi2c)
{
	if(hi2c->Instance == I2C1)
	{
		i2c_TxInterrupts++;
	}
}

void HAL_I2C_MasterRxCpltCallback(I2C_HandleTypeDef *hi2c)
{
	if(hi2c->Instance == I2C1)
	{
		i2c_RxInterrupts++;
	}
}

void HAL_UART_TxCpltCallback(UART_HandleTypeDef *huart)
{
	if(huart->Instance == USART1)
	{
		Uart_TxInterrupts++;
	}
}

void HAL_UART_RxCpltCallback(UART_HandleTypeDef *huart)
{
	uint8_t i;
	if(huart->Instance == USART1)//Current UART
	{
		if(Rx_indx == 0)
		{
			for(i=0; i<100; i++)
			{
				Rx_Buffer[i]=0; //Clear rx_Buffer prior to use
			}
			//reset the user led if previously set
			HAL_GPIO_WritePin(GPIOC, GPIO_PIN_13, GPIO_PIN_RESET);
		}
		if(Rx_data[0]!=13)
		{
			Rx_Buffer[Rx_indx++] = Rx_data[0]; //add data to rxbuffer
		}
		else // if received data =13 (carriage return)
		{
			Rx_indx =0;
			Transfer_cplt =1; // transfer complete, data is ready
			HAL_UART_Transmit_DMA(&huart1,(uint8_t*)Rx_Buffer,(uint16_t)strlen(Rx_Buffer));
			HAL_UART_Transmit_DMA(&huart1,(uint8_t*)"\n\r",2u);
			if(!strcmp(Rx_Buffer,"On"))// LED trigger phase
			{
				HAL_GPIO_WritePin(GPIOC, GPIO_PIN_13, GPIO_PIN_SET);
			}
		}
		HAL_UART_Receive_DMA(&huart1,(uint8_t*)Rx_data,1u);// activate UART
		HAL_UART_Transmit_DMA(&huart1,(uint8_t*)Rx_data,(uint16_t)strlen(Rx_data));
	}
}


void HAL_GPIO_EXTI_Callback(uint16_t GPIO_Pin)
{
	if (GPIO_Pin == GPIO_PIN_4){
		if((HAL_GPIO_ReadPin(GPIOB, GPIO_PIN_4) == GPIO_PIN_RESET)){
			/* Falling edge */
			MENU_keyPressed(&menu);
			MENU_Task(&menu);
			print_normal_Menu();
		}else{
			/* Rising edge */
		}
	}
}

/* USER CODE END 0 */

/**
  * @brief  The application entry point.
  * @retval int
  */
int main(void)
{
  

  /* MCU Configuration--------------------------------------------------------*/

  /* Reset of all peripherals, Initializes the Flash interface and the Systick. */
  HAL_Init();

  /* Configure the system clock */
  SystemClock_Config();

  /* Initialize all configured peripherals */
  MX_GPIO_Init();
  MX_TIM2_Init();
  MX_DMA_Init();
  MX_USART1_UART_Init();
  MX_TIM4_Init();
  MX_SPI1_Init();
  MX_ADC1_Init();
  MX_TIM1_Init();
  MX_I2C2_Init();
  MX_TIM3_Init();
  /* USER CODE BEGIN 2 */
	(void)HAL_UART_Receive_DMA(&huart1, (uint8_t*)Rx_data, 1u);
	LCD_init(&Lcd, &Lcd_Hd44780I2cCfg); /* Initialize the LCD to print "normal characters"*/
	BIGFONT_init(&Lcd); /*Initialize Big font characters */
	LCD_setBacklight(&Lcd, 1u); /* Turn on the Backlight */
	DS1302_Init(&rtc, &ds1302_config);
	DS1302_setTime(&rtc, HOUR_FORMAT, HOUR, MINUTES, SECONDS, AM_PM, WEEKDAY, MONTHDAY, MONTH, YEAR);
	SDBG_print(&huart1,"\r\nHello World!");
	MENU_Init(&menu, &menu_configs, &menu_dateTimeCfg, &menu_alarmCfg, &menuPidCfg);
	PID_init(&Pid, &pidcfg);

	if(HAL_OK != HAL_ADCEx_Calibration_Start(&hadc1)){
		Error_Handler();
	}

	if(HAL_OK != HAL_ADC_Start_DMA(&hadc1, (uint32_t*)&adc_buffer, ADC_BUFFER_LEN)){
		Error_Handler();
	}

	if(HAL_OK != HAL_TIM_Base_Start_IT(&htim1)){
		Error_Handler();
	}

	if(HAL_OK != HAL_TIM_Base_Start_IT(&htim3)){
		Error_Handler();
	}
  /* USER CODE END 2 */

  /* Infinite loop */
  /* USER CODE BEGIN WHILE */
	while (1)
	{
		if(flag_timer1){
			DS1302_updateDateTime(&rtc);

			MENU_SetSecondUnits(&menu, DS1302_getSecondsUnits(&rtc));
			MENU_SetSecondDec(&menu, DS1302_getSecondsDec(&rtc));
			MENU_SetMinutesUnits(&menu, DS1302_getMinutesUnits(&rtc));
			MENU_SetMinutesDec(&menu, DS1302_getMinutesDec(&rtc));
			MENU_SetHourUnits(&menu, DS1302_getHourUnits(&rtc));
			MENU_SetHourDec(&menu, DS1302_getHourDec(&rtc));
			MENU_SetAmPm(&menu, DS1302_getAmPmStatus(&rtc));
			MENU_SetWeekday(&menu, DS1302_geWeekDay(&rtc));
			MENU_SetMonth(&menu, DS1302_getMonth(&rtc));
			MENU_SetMonthDay(&menu,DS1302_getMonthDay(&rtc));
			MENU_SetYear(&menu, DS1302_getYear(&rtc));
			flag_timer1 = 0;
		}

		if(MENU_GetChangesDataTime(&menu)){
			DS1302_setTime(&rtc, menu.data.dateTimeCfg.hourFormat, menu.data.dateTimeCfg.hour, menu.data.dateTimeCfg.minutes, menu.data.dateTimeCfg.seconds,
					menu.data.dateTimeCfg.amPm, menu.data.dateTimeCfg.dayOfWeek, menu.data.dateTimeCfg.dayOfMonth, menu.data.dateTimeCfg.month, menu.data.dateTimeCfg.year);
		}

		if(MENU_GetChangesPid(&menu)){
			PID_SetSetPointVal(&Pid, menu.data.SetPointEntire, 0U);
			PID_SetParameters(&Pid, menu.data.kpEntire, menu.data.kpDecimal,
					menu.data.kiEntire, menu.data.kiDecimal,
					menu.data.kdEntire, menu.data.kdDecimal);
		}

		if(MENU_checkAlarm(&menu)){

		}

    /* USER CODE END WHILE */

    /* USER CODE BEGIN 3 */
	}
  /* USER CODE END 3 */
}

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
