cristobalgc/STM32_PID_CONTROLLER/(commit log)

2020-01-26 Testing I2C, USART, TIMERS and printing numbers in LCD
    [New_configuration.cfg]
2020-05-01 Updated interrupt priorities.Enabled UART debug port. Actualized LCD_I2C library
2020-05-17 Uprated PID, RTCM, and DS1302 libraries
2020-11-08 Added PCB schematic design and PCB documentation
    [BOM.xlsx, PCB_ST.pdsprj, PLANOS.dwg]
2020-12-15 Minor changes on PCB design
    [PCB_ST.pdsprj]
2021-01-02 Minor changes on the board design
    [PCB_ST.pdsprj]
2021-04-18 Updated PCB to add 2 more pwm outputs for RGB leds
    [EC11E12-15P30C-SW.stp, PCB_ST.pdsprj, STM32F103C8T6_Blue_Pill.stp, XH2.54 3p.stp]
2021-04-18 Updated Pcb design, minor changes, deleted unused files
    [PCB_ST.pdsprj]
2021-05-16 Updated new PID version with new features
2021-09-15 Updated Pcb design and modified the source code
    [PCB_ST.pdsprj]
2021-09-26 Updated software for PID controller
2021-10-03 Updated Menu and Pid software components
2022-01-22 Updated pcb design to suport DS1302
    [PCB_ST.pdsprj]
2022-02-13 Updated Hw to version 1.0.0, updated documentation
    [BOM.xlsx, LCD20x4.dxf, PCB_ST.pdsprj, PLANOS.dwg]
2022-05-07 Updated PCB design. Enabled i2c2 peripheral to use the LCD
    [PCB_ST.pdsprj]
